Shreyas-SK-21/Braille-Reading-Analysis-System/Manuscript_Draft/diff_heatmap.pdf

Ant 1.41 | Ant 1.41 | Socks 1.22 | Socks 1.22 | Socks 1.22 | Alligator 0.99 | Alligator 0.99
Snail 0.33 | Snail 0.33 | Turtle 0.19 | Turtle 0.19 | Turtle 0.19 | Pen 0.79 | Pen 0.79
Fish 0.79 | Fish 0.79 | Switch 1.04 | Switch 1.04 | Switch 1.04 | Switch 1.04 | Knot 0.00
Cow 1.02 | Cow 1.02 | Egg 0.71 | Egg 0.71 | Elephant 0.99 | Elephant 0.99 | Elephant 0.99
Hen 0.33 | Hen 0.33 | Moon 0.60 | Moon 0.60 | Moon 0.60 | House 0.79 | House 0.79
Mango 0.69 | Mango 0.69 | Mango 0.69 | Mat 0.78 | Mat 0.78 | Scissors 0.94 | Scissors 0.94
Grape 0.66 | Grape 0.66 | Grape 0.66 | Fog 0.39 | Fog 0.39 | Frog 1.20 | Frog 1.20
