Shreyas-SK-21/Braille-Reading-Analysis-System/Manuscript_Draft/skip_heatmap.pdf

Ant 2 | Ant 2 | Socks 3 | Socks 3 | Socks 3 | Alligator 4 | Alligator 4
Snail 2 | Snail 2 | Turtle 2 | Turtle 2 | Turtle 2 | Pen 2 | Pen 2
Fish 1 | Fish 1 | Switch 2 | Switch 2 | Switch 2 | Switch 2 | Knot 1
Cow 2 | Cow 2 | Egg 1 | Egg 1 | Elephant 2 | Elephant 2 | Elephant 2
Hen 2 | Hen 2 | Moon 1 | Moon 1 | Moon 1 | House 2 | House 2
Mango 1 | Mango 1 | Mango 1 | Mat 1 | Mat 1 | Scissors 3 | Scissors 3
Grape 3 | Grape 3 | Grape 3 | Fog 2 | Fog 2 | Frog 5 | Frog 5
