Shreyas-SK-21/Braille-Reading-Analysis-System/Manuscript_Draft/tot_heatmap.pdf

Ant 1290 | Ant 1290 | Socks 1546 | Socks 1546 | Socks 1546 | Alligator 1548 | Alligator 1548
Snail 2580 | Snail 2580 | Turtle 3096 | Turtle 3096 | Turtle 3096 | Pen 1806 | Pen 1806
Fish 3093 | Fish 3093 | Switch 4131 | Switch 4131 | Switch 4131 | Switch 4131 | Knot 1543
Cow 2065 | Cow 2065 | Egg 3611 | Egg 3611 | Elephant 2835 | Elephant 2835 | Elephant 2835
Hen 2064 | Hen 2064 | Moon 4643 | Moon 4643 | Moon 4643 | House 1548 | House 1548
Mango 5673 | Mango 5673 | Mango 5673 | Mat 3098 | Mat 3098 | Scissors 1718 | Scissors 1718
Grape 1889 | Grape 1889 | Grape 1889 | Fog 1808 | Fog 1808 | Frog 1134 | Frog 1134

2000

3000

4000

5000

Dwell Time (ms)
