Shreyas-SK-21/Braille-Reading-Analysis-System/Manuscript_Draft/final_draft.pdf

# A Low-Cost Conductive Grid System for Real-Time Multi-Metric Braille Reading Performance Analysis

Abstract—Objective assessment of Braille reading proficiency remains essential yet underserved, with existing tools either prohibitively expensive or unsuitable for widespread classroom deployment. This paper presents a scalable, low-cost conductive grid-based sensing system that detects multi-touch interactions over a 7 × 7 Braille sensing grid in real time. An ESP32 microcontroller drives a multiplexed row-column scanning architecture, streaming capacitively coupled touch frames to a host system over USB-serial. A multi-threaded Python pipeline computes seven complementary performance metrics: rolling Words per Minute (WPM) with exponential moving average smoothing, velocity profile inter-quartile range (IQR) as a motor-consistency indicator, inter-word regression rate and hesitation analysis, word-level Time-on-Task (ToT), grid coverage and skip-rate analysis, path efficiency with LOWESS trend fitting, and a composite difficulty score that unifies all signals into a per-word indicator. The system operates without any wearable device or optical apparatus, providing an unobtrusive, low-cost platform for diagnosing Braille reading proficiency in classroom and research settings.
Index Terms—Braille reading, conductive grid, touch sensing, capacitive coupling, ESP32, finger tracking, WPM, time-on-task, regression analysis, path efficiency, motor consistency, accessibility, low-cost assistive technology
I. INTRODUCTION

Braille literacy remains a cornerstone of independence and academic achievement for individuals who are blind or visually impaired. Research consistently demonstrates that Braille-literate individuals enjoy substantially higher employment rates [1]; however, the National Federation of the Blind reports a severe literacy crisis wherein nearly 90% of blind children are not being taught to read and write Braille [2]. The World Health Organization further reports that vision impairment carries an annual global productivity loss of approximately US$ 411 billion [3], underscoring the economic imperative of effective tactile literacy programmes. Yet despite this importance, tools for objectively measuring and improving Braille reading skills remain scarce, expensive, and inaccessible to most educators and learners. Martiniello and Wittich [4] confirm in a comprehensive scoping review that Braille reading performance is determined by at least three independent capacity dimensions including tactile sensitivity, manual dexterity, and cognitive processing, underscoring why aggregate WPM alone is insufficient for diagnostic assessment. A systematic review of technology-supported Braille literacy education for children [5] further confirms that while electronic tools support Braille output, real-time performance monitoring systems remain absent from classroom practice, a gap the proposed platform directly addresses.

Knowlton and Wetzel [6] reported a mean Braille reading speed of 136 words per minute (WPM) for experienced readers in controlled reading tasks, with a range of 65–185 WPM. While some literature claims that highly proficient readers can achieve rates between 200 and 400 WPM [7], reflecting the upper tail of expert performance, beginners typically read at only 50-70 WPM. Understanding why a reader is slow, whether due to uneven finger movement, frequent backtracking, or inefficient reading patterns requires instrumentation that captures more than aggregate reading speed. Existing systems for analyzing Braille reading rely on vision-based tracking, wearable sensors [8]–[10], or dedicated electronic displays, all of which are intrusive, expensive, or impractical for widespread deployment.
While low-cost real-time tactile tracking has been successfully demonstrated in other contexts such as interactive museum exhibits [11], [12], there is a pressing need to adapt such non-invasive approaches to capture continuous Braille reading interaction data. This includes tracking finger movement patterns, per-cell reading durations, total reading time, and average reading rate without instrumenting the reader. This paper presents such a system. A passive conductive grid placed beneath a 7 × 7 Braille sensing grid detects finger contact events through capacitive coupling; a multi-threaded software pipeline then computes seven complementary metrics that together profile both reading fluency and motor consistency. The key contributions of this work are:
- A low-cost, non-invasive conductive grid system capable of localizing touch interactions on a physical Braille page in real time.
- A comprehensive multi-metric analysis of Braille reading performance by quantifying reading fluency, fingermotion stability, regressions and hesitations, time-on-task behavior, reading coverage, path efficiency, and overall word-level difficulty.

II. RELATED WORK

Prior approaches to Braille reading analysis can be broadly categorized into four classes: marker-based tracking systems, wearable sensor systems, software-based tablet solutions, and vision-based and electronic approaches.
Early Braille-reading studies relied on external tracking hardware to capture finger motion. Hughes [13] used a digitizing tablet to analyze Braille reading kinematics, revealing frequent velocity fluctuations and smoother motion profiles among skilled readers. Similarly, Aranyanak and Reilly [14]

developed a Wiimote-based infrared tracking system that monitored LEDs attached to readers’ fingers while supporting both embossed Braille and refreshable displays. Although these systems provide valuable movement data, they require markers to be attached to the reader, careful calibration, and specialized hardware that limits practical classroom deployment. Several wearable approaches have been proposed for Braille reading assistance and analysis. Recent motion-sensor based systems like BrailleReader [15] leverage wrist kinematics for Braille tracking, while the Finger-Eye system [16] combines a miniature camera with electro-tactile feedback to guide users during reading. While these approaches can achieve high precision, they require users to wear and calibrate additional hardware, potentially altering the natural reading experience. Building on earlier camera-based finger-tracking systems for Braille [17], Aranyanak [18] replaced the camera with a capacitive touchscreen, proposing a tablet-based finger-tracking system in which transparent Braille paper is placed over the screen. The system records finger movement patterns, reading durations, and reading speed while preserving a largely non-invasive interaction. However, it is limited to specific tablet hardware, supports only two-finger tracking, and constrains the reading area to the dimensions of the touchscreen. More recently, Marzi et al. [19] extended surface-based finger-tracking to the analysis of reading pace, word-level dwell time, and regression frequency in ASD children, demonstrating that non-invasive, touchscreen-based trajectory recording can yield diagnostically meaningful multi-metric profiles, a capability the proposed system brings to physical embossed Braille. Refreshable Braille displays with integrated sensing capabilities are commercially available but are often expensive and restricted to electronic content. Even recent low-cost display innovations such as BLISS [20], which reuses Braille pins for multi-character display, remain hardware-intensive output devices unsuited to the passive sensing role required for reading behavior analysis. State-of-the-art electromagnetic Braille displays [21] achieve reliable multi-cell actuation but provide no mechanism for capturing or analyzing how a reader interacts with the content. Vision-based approaches use cameras and computer-vision algorithms to track finger movement [17], but are sensitive to lighting conditions, occlusion, reader posture, and privacy concerns, making reliable deployment challenging. A common limitation across prior work is the extraction of only a limited set of performance metrics, typically reading speed or error rate. Kong et al. [22] demonstrated that 15 mathematically formalized touch metrics including touch drift, direction, and area variability to differentiate between finemotor-impaired and unimpaired users on capacitive touch screens, establishing a framework that parallels and motivates our multi-metric approach for Braille interaction. No existing low-cost system simultaneously tracks velocity consistency, word-level dwell time, regression patterns, skip rate, and path efficiency within a unified real-time pipeline. The proposed system addresses this gap.
Table I provides a qualitative comparison across four practical dimensions: cost, invasiveness, real-time operation, and

TABLE I
COMPARISON OF BRAILLE READING ANALYSIS SYSTEMS
System | Low Cost | Non-Invasive | Real-Time | Vision Free | Per-word Metrics
Marker-based [13], [14] Wearable [15], [16] Tablet touch [18] Vision-based [17] Braille display [21], [23] Proposed | ✓ ✓ ✓ ✓ × ✓ | × × ✓ ✓ ✓ ✓ | ✓ ✓ ✓ ✓ ✓ ✓ | ✓ ✓ ✓ × ✓ ✓ | × × Limited × × ✓

Per-word Metrics includes simultaneous real-time tracking of WPM, velocity IQR, regression rate, time-on-task, skip rate, path efficiency η, and composite difficulty D.

per-word metric granularity. No currently published system provides a directly comparable low-cost, real-time, multi-metric pipeline against which head-to-head quantitative benchmarking is possible. Our core objective was to automate a process currently performed manually—recording sessions on video and analyzing finger movement post-hoc—which is time-consuming and impractical for classroom-scale use. Quantitative benchmarking against an external reference system is planned as part of the forthcoming evaluation with visually impaired readers.

III. PROPOSED SYSTEM

A. System Overview
The proposed system consists of three components: (i) a passive conductive grid embedded beneath a Braille reading surface, with software-defined mapping between Braille content and grid coordinates; (ii) an ESP32 microcontroller board that drives multiplexed row–column scanning and streams capacitively coupled touch frames to a host system over USB– serial; and (iii) a multi-threaded Python software pipeline that computes seven reading performance metrics in real time and renders a eight-panel live visualization suite. No modifications to the Braille page or the reader’s hands are required.
The system actively tracks dual-finger interactions using a proximity-based peak-lock assignment algorithm. This allows it to explicitly capture multi-finger reading strategies like the butterfly and side-by-side patterns while calculating independent metrics for each finger.
B. Hardware Design
1) Cost-Efficient Conductive Grid Architecture: The sensing layer is a 7 × 7 prototype matrix of conductive copperstrip traces, providing 49 sensing locations mapped to single word positions. The physical layout is shown in Fig. 1. It is important to note that the 7 × 7 grid presented in this study serves as an evaluative mockup: to accurately mimic the spatial layout of an authentic embossed Braille sheet placed over the system, a single logical word is assigned across multiple contiguous sensing cells, with the number of cells proportional to the word’s character length. A defining feature of this prototype is its extreme cost-efficiency. The sensing grid is constructed entirely from commodity copper tape, which retails for under $0.50 per metre. The data acquisition is driven by an ESP32 microcontroller development board, available for approximately $4–5 USD. The only comparatively expensive component is the pair of analog multiplexer ICs (CD4051) required for row–column switching, at roughly $0.80 USD total. Even with all passive components, cabling, and a perfboard, the complete hardware bill of materials is bounded at approximately $14–18 USD per unit. While it does not replace the spatial precision of laboratory eyetracking rigs or high-end instrumented Perkins Braillers, this $18 proof-of-concept provides a highly scalable, accessible alternative for resource-constrained environments (e.g., public school classrooms) where $10,000 systems are prohibitively expensive.

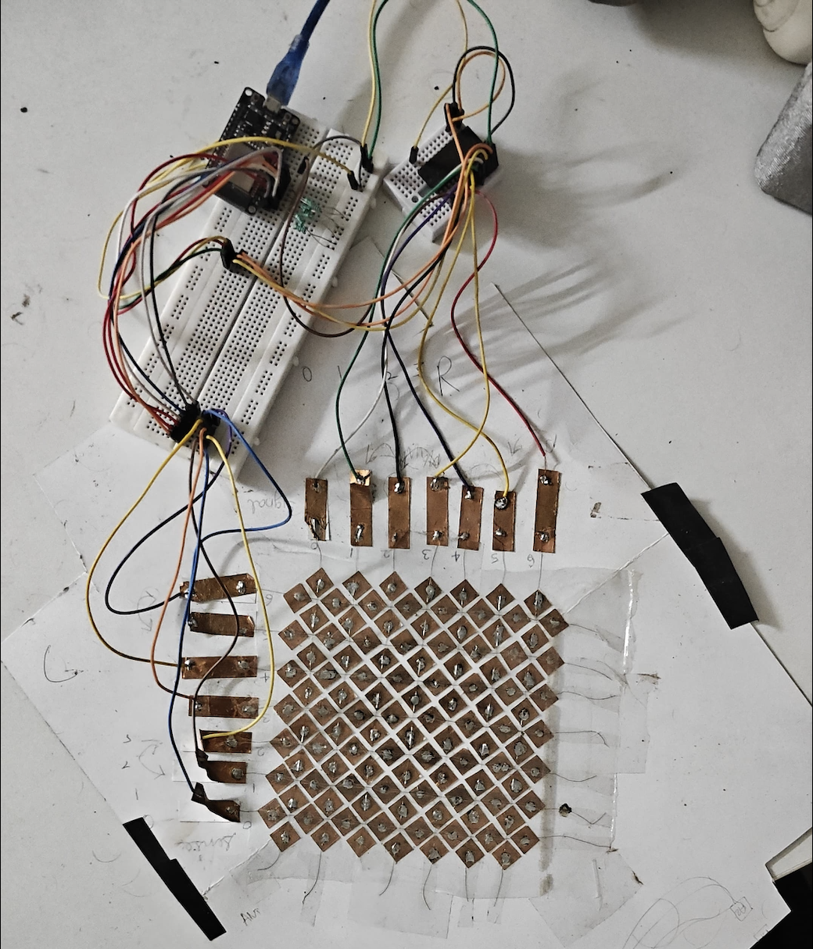
[picture p10: figure]

Fig. 1. Physical layout of the 7 × 7 conductive grid with ESP32 controller board.
2) Excitation Signal and Scanning: A hardware timer generates a ∼100 KHz square-wave excitation signal. Electromagnetic interference (EMI) rejection relies on software-based baseline subtraction and amplitude thresholding rather than passive filtering. The AC carrier is routed through each selected transmit (TX) row in turn, and capacitively coupled signals are detected on the receive (RX) column lines when a finger bridges an intersection.
A 3-bit multiplexer selects one TX row at a time, followed by a 25 µs settling delay to allow the RC network to stabilize before sampling the RX columns. Each ADC reading averages 30 successive 12-bit samples to filter noise. Touch-induced differential signals fall within the 0.15–2.8 V range, avoiding the ESP32 ADC’s non-linear regions near the voltage rails. This process generates a full 7 × 7 activation frame per scan cycle, transmitted to the host via USB-serial.
C. Firmware Flowchart
Fig. 2 illustrates the ESP32 firmware control flow, which orchestrates the complete scan–filter–transmit cycle. The main loop iterates over all seven TX rows, selects each via the multiplexer, and reads all seven RX columns with a 30-sample averaged ADC filter. Frame timestamps are derived from the microcontroller’s hardware timer to support latency measurement. The resulting 7 × 7 activation matrix is transmitted to the host.

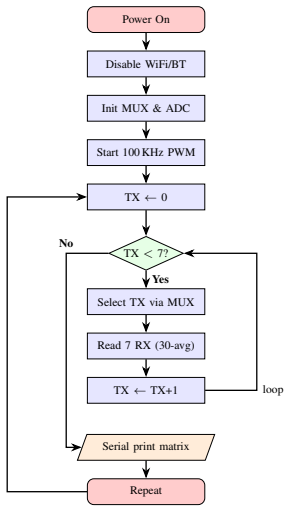
[picture p11: figure]
Power On; Disable WiFi/BT; Init MUX & ADC; Start 100 KHz PWM; Select TX via MUX; Read 7 RX (30-avg); Serial print matrix; Repeat; Yes; loop

Fig. 2. ESP32 firmware control flow: multiplexed row scanning with filtered ADC readout and serial transmission.

D. Software Pipeline
The host-side pipeline runs three concurrent threads: a reader thread that flushes stale serial data and posts the most recent 7×7 frame to a bounded queue, a metrics thread that dequeues frames, runs touch detection, and updates all tracker objects, and a UI thread that reads metric snapshots and renders the visualisation suite. All tracker classes expose an asynchronous snapshot method to decouple high-speed sensing from UI rendering. The pipeline is illustrated in Fig. 3.

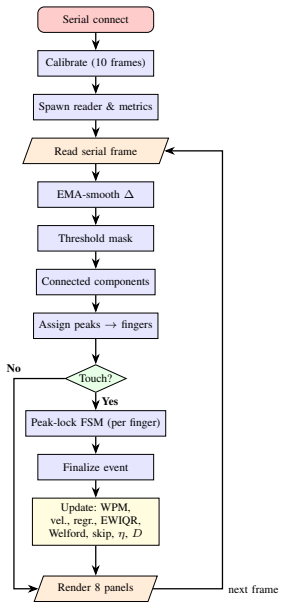
[picture p12: figure]
Serial connect; Calibrate (10 frames); Spawn reader & metrics; Read serial frame; EMA-smooth ∆; Threshold mask; Connected components; Assign peaks → fingers; Touch?; Peak-lock FSM (per finger); Finalize event; Update: WPM, vel., regr., EWIQR, Welford, skip, η, D; Render 8 panels; Yes; next frame

Fig. 3. Software pipeline: three-thread serial ingestion, dual-finger touch detection via connected-component analysis and per-finger peak-lock FSM, eight metric trackers (D = composite difficulty score), and eight-panel live visualisation.
Raw activation frames are processed by a 4-connected component algorithm that clusters adjacent activated cells into discrete touch events. Each event is assigned a centroid coordinate, a timestamp, a duration and a word_label derived from a pre-calibrated mapping of grid coordinates to the word boundary dictionary. A peak-lock finite state machine stabilizes the detected cell across frames and detects mid-touch slides when the finger moves ≥2 cells (Manhattan distance), automatically finalizing the current event and starting a new one without requiring lift-off.
The system dynamically maps varying physical column widths to word boundaries using a software-defined dictionary. A WordGroupAccumulator gates word registration until all multi-block segments of a single word have been traversed. WPM is then computed over a 60-second rolling window: where nw(t) is the touch count within ∆T = 60 s. An EMA with α = 0.15 is applied after a median pre-filter (window=3) to reduce per-frame variance, also expressed in the Equation 1, where x˜t is the median-filtered WPM sample. The smoothing factor α = 0.15 was selected heuristically to balance lag against variance: smaller values suppress measurement jitter but delay trend detection, while larger values track instantaneous speed bursts at the cost of noise amplification. The chosen value yields an effective memory window of approximately 1/α ≈ 7 samples, which aligns with the expected temporal scale of deliberate reading-speed changes during a session.
WPM \t = α · x˜t + (1 − α) · WPM \t−1 | (1)

The Velocity-Tracker employs an exponentially weighted IQR (EWIQR) algorithm with decay factor of λ = 0.95. For each touch event, the velocity profile (cells/s) between consecutive path steps is recorded with exponentially decaying weights as expressed in the Equation 2: , where clamp(x, a, b) = min(max(x, a), b) constrains the result to the interval [a, b]; here a = 0 and b = 1 ensure Cs remains a valid normalized score.

v¯ =

P
| i wivi

P
i wi

,
IQR = Q75 − Q25,
Cs = clamp
1 −

IQR
max(¯v, ε)

, 0, 1

(2)

This formulation is motivated by Nonaka et al. [24], who demonstrated that the inter-event structure of lateral-velocity fluctuations longitudinally predicts Braille reading proficiency in blind children, establishing velocity variability as a principled motor-consistency indicator.
A regression occurs when the reader returns to a previously touched word. The Word-Stats-Tracker maintains a seen set mapping words to their last-touch timestamp. To prevent false regressions during prolonged reading or multi-pass exploration, a time-windowed regression algorithm is employed: a touch is only counted as a regression if the same cell was touched within a 30-second temporal window. Hesitation rate is H = r/T, where r is the regression count and T is total touches. Words with regression count > 3 are flagged as difficulty candidates.

Time-on-Task for word w is the mean contact duration, calculated continuously using a Welford online algorithm. A 7×7 numpy array ZToT is maintained for the 2D performance heatmap visualization.
Considering N as the total number of mapped word regions (49 selected in the current 7 × 7 prototype), Skip rate is defined as: A BFS cluster analysis classifies skip patterns into categories (sensing failure, column alignment, boundary avoidance, saccade drift).
The path efficiency is defined as per the Equation 3, where dstraight is the Euclidean distance between the first and last cells visited within a touch event, and dactual is the cumulative arc length of the detected finger path. A LOWESS trend (f =
0.3) is recomputed every 10 events.

η =

dstraight

dactual

, | η ∈ (0, 1], | (3)

The composite difficulty score D(e) for a touch event e aggregates four kinematic and behavioral signals into a single indicator of reading effort:

D(e) = w1REV(e) + w2ZC(e) + w3VEL(e) + w4WREV(e)
| | (4)
where REV(e) represents the number of within-touch path direction reversals, ZC(e) denotes the count of zero-crossings in the velocity profile indicating hesitation, VEL(e) = ¯v/(¯v +
1) ∈ [0, 1) is a normalized speed term that increases toward unity as mean finger velocity v¯ increases, and WREV(e) is a binary flag indicating if the event constitutes a sessionlevel inter-word regression. The word-level difficulty D(w) is then computed as the arithmetic mean of D(e) for all events mapped to word w. In the current prototype, the heuristic weights are set to w1 = 1.0, w2 = 0.5, w3 = 2.0, and w4 = 1.5. These weights were empirically chosen to prioritize regression penalties. Exploratory Principal Component Analysis (PCA) revealed that sighted participants exhibit a tactile “scrubbing” behavior (high hesitation correlating with high velocity), which inverts the kinematics of proficient blind readers. Thus, deriving static statistical weights was deliberately deferred to future clinical studies to prevent overfitting to sighted behavior. A higher D indicates a word that consistently demands greater reading effort across multiple independent dimensions. Reading difficulty variance is rendered as a switchable view in the 7 × 7 2D performance heatmap, driven by an Exponentially Weighted Interquartile Range (EWIQR) of touch durations, which isolates current reading inconsistency.

IV. EXPERIMENTAL RESULTS AND DISCUSSION
The results presented in this section were obtained through a pilot evaluation conducted with sighted participants interacting with the 7 × 7 grid surface. This evaluation was performed to validate system functionality, metric computation, and visualization pipeline. These results should be interpreted as a proof-of-concept demonstration of system capability; formal user studies with visually impaired Braille readers remain as future work (Section V).

A. Experimental Setup and Pilot Protocol

To characterize system performance and validate the software pipeline, empirical hardware tests were conducted across multiple independent reading sessions. To accommodate the variety of target words on the prototype’s 7 × 7 spatial footprint, different sets of words were mapped and tested in separate passes. The integrated system successfully processed continuous touch events across all 49 grid positions in real-time, yielding rich datasets for metric extraction. Sighted participants were blindfolded to eliminate visual feedback, strictly isolating tactile exploration and mirroring the operational constraints of visually impaired readers. The 7 × 7 evaluation grid assigns each logical word across one or more contiguous sensing cells based on character length, mimicking the spatial layout of an authentic embossed Braille sheet.

B. WPM Accuracy and EMA Stability

The two-stage median→EMA pipeline (Eq. 1, α = 0.15) significantly reduces per-frame WPM variance relative to raw rolling counts. Fig. 4 shows a time series extraction demonstrating the smoothed EMA trend overlaid on the raw windowed count. By mitigating localized noise from finger jitters, the pipeline provides a stable, continuous reading speed metric that accurately reflects the user’s tactile reading pace against established novice benchmarks [6].

0 | 10 | 20 | 30 | 40 | 50

0

10

20

30

40

17 WPM (novice floor)

Touch event index

WPM

Raw rolling WPM
EMA trend (α=0.15)

Fig. 4. WPM time series extraction: raw rolling count (grey) with median→EMA trend overlay (α = 0.15, blue). Dashed reference marks the established novice tactile reading floor [6].

C. Velocity IQR and Motor Consistency

Fig. 5 shows the velocity profile overlay for a a continuous reading sample. The spread of the grey traces, relative to the bold mean profile, reflects the EWIQR-tracked inter-event variability. A narrowing spread over an evaluation period indicates improving motor consistency, captured by Cs (Equation 2).

0 | 2 | 4 | 6

0

2

4

6

Path step

Velocity (cells/s)

Past traces
Latest trace
Weighted mean

Fig. 5. Velocity profile overlay: grey traces = past 20 events; blue = most recent; dashed orange = exponentially weighted mean. Spread of grey traces reflects EWIQR-tracked motor variability.

D. Hesitation Rate and Regressions
Fig. 6 shows the regression frequency chart generated by the Word-Stats-Tracker. Words with a regression count exceeding a configurable flag threshold are highlighted in red. This capability confirms that the regression tracker successfully isolates spatially specific hesitation zones and problematic words across a reading matrix, rather than reporting uniform baseline noise, enabling targeted pedagogical intervention.
0.0 | 0.5 | 1.0 | 1.5 | 2.0 | 2.5 | 3.0
Regression Count

Alligator

Frog

Socks

Scissors

Grape

Elephant

Cow

Ant

Hen

Pen

House

Snail

Switch

Turtle

Fig. 6. Regression frequency chart (aggregated system evaluation data): red bars mark flagged words whose regression counts exceed a configured threshold, demonstrating the system’s ability to isolate spatially localised hesitation targets.
Words flagged by the regression tracker overlapped with high composite difficulty scores, confirming convergent validity across independent metrics. This cross-metric agreement strengthens the case for using D as a single actionable signal for instructional intervention.
Figs. 7 and 8 show the 2D performance heatmaps generated by the visualization pipeline. The Time-on-Task (ToT) metric provides high-resolution temporal profiles for individual Braille cells, directly reflecting the motor difficulty and dwell time of specific segments. The composite difficulty score D effectively aggregates these signals, identifying the highesteffort regions across the reading matrix independent of simple Time-on-Task. For instance, Ant (D = 1.41) and Socks (D = 1.22) dominate as the hardest words by composite difficulty.
C0 | C1 | C2 | C3 | C4 | C5 | C6

R0

R1

R2

R3

R4

R5

R6

1290
(Ant)

1290
(Ant)

1545
(Socks)

1545
(Socks)

1545
(Socks)

1548
(Alligator)

1548
(Alligator)

2580
(Snail)

2580
(Snail)

3095
(Turtle)

3095
(Turtle)

3095
(Turtle)

1805
(Pen)

1805
(Pen)

3093
(Fifth)

3093
(Fifth)

4130
(Switch)

4130
(Switch)

4130
(Switch)

4130
(Switch)

1542
(Knot)

2064
(Cow)

2064
(Cow)

3611
(Egg)

3611
(Egg)

2834
(Elephant)

2834
(Elephant)

2834
(Elephant)

2063
(Hen)

2063
(Hen)

4643
(Moon)

4643
(Moon)

4643
(Moon)

1548
(House)

1548
(House)

5672
(Mango)

5672
(Mango)

5672
(Mango)

3098
(Mat)

3098
(Mat)

1717
(Scissors)

1717
(Scissors)

1889
(Grape)

1889
(Grape)

1889
(Grape)

1808
(Fog)

1808
(Fog)

1134
(Frog)

1134
(Frog)

2000

3000

4000

5000

Dwell Time (ms)

Fig. 7. 7 × 7 Time-on-Task heatmap (aggregated empirical data, ms). Blue intensity encodes mean dwell time; darker = longer. Variations in dwell time are visualized to pinpoint reading struggles. Note: To visualize regional difficulty, cognitive metrics (such as dwell time) are aggregated at the logical word-level and projected uniformly across the spatial grid cells occupied by that word.

C0 | C1 | C2 | C3 | C4 | C5 | C6

R0

R1

R2

R3

R4

R5

R6

1.41
(Ant)

1.41
(Ant)

1.22
(Socks)

1.22
(Socks)

1.22
(Socks)

0.99
(Alligator)

0.99
(Alligator)

0.33
(Snail)

0.33
(Snail)

0.19
(Turtle)

0.19
(Turtle)

0.19
(Turtle)

0.79
(Pen)

0.79
(Pen)

0.79
(Fifth)

0.79
(Fifth)

1.04
(Switch)

1.04
(Switch)

1.04
(Switch)

1.04
(Switch)

0.00
(Knot)

1.02
(Cow)

1.02
(Cow)

0.71
(Egg)

0.71
(Egg)

0.99
(Elephant)

0.99
(Elephant)

0.99
(Elephant)

0.33
(Hen)

0.33
(Hen)

0.60
(Moon)

0.60
(Moon)

0.60
(Moon)

0.79
(House)

0.79
(House)

0.69
(Mango)

0.69
(Mango)

0.69
(Mango)

0.78
(Mat)

0.78
(Mat)

0.94
(Scissors)

0.94
(Scissors)

0.66
(Grape)

0.66
(Grape)

0.66
(Grape)

0.39
(Fog)

0.39
(Fog)

1.20
(Frog)

1.20
(Frog)

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
Composite Difficulty (D)

Fig. 8. 7 × 7 composite difficulty heatmap (aggregated empirical data D). Red (D ≥ 0.90) = high effort; yellow (0.50 ≤ D < 0.90) = moderate; white = low. The metric effectively isolates the hardest regions. Note: Similar to Time-on-Task, difficulty scores are aggregated at the word-level and projected onto corresponding cells.

E. Skip Rate and Grid Coverage
The coverage heatmap (Fig. 9) shows the spatial distribution of total touch counts across the grid positions, demonstrating the system’s ability to map spatial exploration. By highlighting baseline touches and heavily revisited regions, the metric verifies that the hardware captures complete grid coverage while mapping spatial inconsistencies. Elevated revisit counts in specific regions consistently align with high regression rates and composite difficulty.
C0 | C1 | C2 | C3 | C4 | C5 | C6

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
(Ant)

2
(Ant)

3
(Socks)

3
(Socks)

3
(Socks)

4
(Alligator)

4
(Alligator)

2
(Snail)

2
(Snail)

2
(Turtle)

2
(Turtle)

2
(Turtle)

2
(Pen)

2
(Pen)

1
(Fifth)

1
(Fifth)

2
(Switch)

2
(Switch)

2
(Switch)

2
(Switch)

1
(Knot)

2
(Cow)

2
(Cow)

1
(Egg)

1
(Egg)

2
(Elephant)

2
(Elephant)

2
(Elephant)

2
(Hen)

2
(Hen)

1
(Moon)

1
(Moon)

1
(Moon)

2
(House)

2
(House)

1
(Mango)

1
(Mango)

1
(Mango)

1
(Mat)

1
(Mat)

3
(Scissors)

3
(Scissors)

3
(Grape)

3
(Grape)

3
(Grape)

2
(Fog)

2
(Fog)

5
(Frog)

5
(Frog)

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
Touch Count

Fig. 9. Grid coverage map (aggregated touch counts). Light green = 1–2 touches; dark green = 3–5 (high revisit rate). The system maps full coverage and successfully highlights heavily re-explored areas without any skipped cells in this session.
Because this representative reading session achieved complete spatial coverage (no unvisited cells), it demonstrates the participant’s thorough tactile scanning. In sessions where skipped cells cluster in lower grid rows, it typically indicates that observation duration, rather than intrinsic word difficulty, drives unvisited regions. Skip rates should therefore be normalized by observation duration when comparing reading behaviors across participants or conditions.
F. Path Efficiency and Composite Difficulty
The path efficiency metric η (Eq. 3) quantifies the directness of the reader’s finger trajectory, distinguishing between discrete, well-centred taps and ambiguous sliding motions. A consistently high η baseline confirms that the physical grid successfully resolves precise tactile interactions, proving the system capable of tracking prolonged reading activity without sensor degradation or baseline drift.
0 | 1 | 2 | 3 | 4 | 5 | 6 0
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
Column

Row

Difficulty

D

0

0.5

1

D

Fig. 10. 7 × 7 composite difficulty surface (aggregated empirical data, hot2 colormap). Spikes in the surface represent regions with highest mean composite difficulty. Grey positions denote unvisited cells.
Analysis of these surface mappings confirms that the composite metric D produces stable, reproducible word-level difficulty profiles rather than transient, session-specific noise, serving as a reliable indicator of pedagogical challenge.
G. System Latency
Real-time tracking requires low end-to-end system latency. The innate hardware latency of the sensing grid and ESP32 transmission, excluding the Python processing pipeline, is approximately 55-60 ms. The Python code computation latency for touch localization, metric updates, and rendering is 33 ms per frame. The combined end-to-end latency is approximately 95 ms, which is well below human perception thresholds for tactile feedback, ensuring highly responsive multi-metric tracking during live reading sessions.
H. Composite Score Sensitivity
The composite difficulty score D currently uses fixed heuristic weights (W1=1.0, W2=0.5, W3=2.0, W4=1.5). To demonstrate the adaptability of the composite score for different pedagogical needs, Table II compares word difficulty rankings across three varying weight configurations. The highdifficulty cluster (Ant, Socks, Frog) dominates across presets, but their relative rankings shift logically: Speed-Focused weights elevate slow-read words like Cow and Socks, while Accuracy-Focused weights strongly penalize high-regression words like Alligator and Frog.

TABLE II
SENSITIVITY ANALYSIS: TOP-7 WORD DIFFICULTY RANKINGS UNDER THREE WEIGHT PRESETS
Rank | Default (W1=1.0, W3=2.0) | Speed-Focused (W3=3.0) | Accuracy-Focused (W1=2.0)
1 2 3 4 5 6 7 | Ant Socks Frog Switch Cow Alligator Elephant | Socks Ant Cow Frog Switch Elephant Alligator | Frog Alligator Socks Ant Switch Cow Elephant
V. LIMITATIONS AND FUTURE WORK
The current prototype is limited by its hand-made 7×7 parallel grid pattern and sequential row-polling scan architecture, which restrict temporal resolution, localization accuracy, and full-page coverage. Furthermore, while the system successfully tracks dual distinct touch points via proximity assignment, it cannot currently determine absolute finger identity or operate at natural reading pressures without potential false touches. Future work will adopt an interleaved, high-resolution grid with continuous parallel sensing to improve spatial and temporal fidelity, as well as investigate alternative low-force sensing modalities.
The primary limitation of this study is that the pilot evaluation was conducted exclusively with sighted participants, and results have not yet been validated with visually impaired Braille readers — the primary target population. Sighted participants rely on visual feedback, lack haptic memory for Braille dot patterns, and produce systematically different regression and skip-rate profiles than experienced blind readers. Consequently, the absolute metric values reported here (WPM, regression rates, composite difficulty scores) should not be interpreted as representative of the target population. Institutional approval has been secured for clinical deployment of this prototype with visually impaired students. The upcoming study protocol will recruit n ≥ 20 participants spanning beginner, intermediate, and advanced Braille readers. The platform’s non-invasive, passive sensing design makes it suitable for classroom deployment without modification, and the sevenmetric pipeline requires no re-calibration between participants. An additional hardware limitation is the signal-to-noise ratio (SNR) attenuation caused by standard dielectric Braille paper (e.g., 120–160 gsm cardstock). The heavy reliance on aggressive software smoothing (such as the α = 0.15 exponential moving average and median filters) is a deliberate engineering trade-off to compensate for this attenuation while using low-cost commodity copper tape. Formal characterization of dielectric attenuation and baseline SNR optimization without heavy software filtering is planned for the next hardware iteration.

VI. CONCLUSION
This paper presented a low-cost, non-invasive conductive grid system for real-time multi-metric analysis of Braille reading behavior. By utilizing commodity copper tape and an ESP32 microcontroller, the prototype captures spatial and temporal reading patterns—including WPM, regression rates, and a composite difficulty score—at a fraction of the cost of commercial alternatives. Pilot evaluations demonstrated the system’s ability to successfully track and isolate reading hesitations and motor inconsistencies through a unified software pipeline. Future work will deploy this scalable, passive sensing platform in formal user studies with visually impaired readers to advance data-driven Braille literacy instruction.

REFERENCES

[1] R. Ryles, “The impact of braille reading skills on employment, income, education, and reading habits,” Journal of Visual Impairment & Blindness, vol. 90, no. 3, pp. 219–226, 1996.
[2] National Federation of the Blind Jernigan Institute, “The braille literacy crisis in america: Facing the truth, reversing the trend, empowering the blind,” tech. rep., National Federation of the Blind, Baltimore, Maryland, 2009.
[3] World Health Organization, World Report on Vision. | Geneva,
Switzerland: WHO, 2019. | https://www.who.int/publications/i/item/
9789241516570.
[4] N. Martiniello and W. Wittich, “The association between tactile, motor and cognitive capacities and braille reading performance: a scoping review of primary evidence to advance research on braille and aging,” Disability and Rehabilitation, vol. 44, no. 11, pp. 2515–2536, 2022.
[5] E. R. Hoskin, M. K. Coyne, M. J. White, S. C. Dobri, T. C. Davies, and S. D. Pinder, “Effectiveness of technology for braille literacy education for children: a systematic review,” Disability and Rehabilitation: Assistive Technology, vol. 19, no. 1, pp. 120–130, 2024.
[6] M. Knowlton and R. Wetzel, “Braille reading rates as a function of reading tasks,” Journal of Visual Impairment & Blindness, vol. 90, no. 3, pp. 227–236, 1996.
[7] G. E. Legge, C. M. Madison, and J. S. Mansfield, “Measuring braille reading speed with the mnread test,” Visual Impairment Research, vol. 1, no. 3, pp. 131–145, 1999.
[8] D. Singhal, Y. Gupta, D. Sharma, C. Sultania, and M. Rao, “Hapticguide: Interactive wearable braille guide for enhancing visual education,” in 2025 38th International Conference on VLSI Design and 24th International Conference on Embedded Systems (VLSID), (Bangalore, India), pp. 73–78, IEEE, 2025.
[9] D. Singhal, C. Sultania, A. Madurwar, M. Kabra, and M. Rao, “Braille on mouse - enhancing accessibility of digital education for visually challenged,” in 2024 16th International Conference on Computer and Automation Engineering (ICCAE), (Melbourne, Australia), pp. 41–45, IEEE, 2024.
[10] C. Sultania, D. Singhal, M. Kabra, A. Madurwar, S. Pawar, and M. Rao, “Wearable haptic braille device for enhancing classroom learning,” in 2023 IEEE SENSORS, (Vienna, Austria), pp. 1–4, IEEE, 2023.
[11] A. Ramesh, N. Raj, T. K. Srikanth, and M. Rao, “Design of a tactile audio gallery for visually impaired students,” in 2019 IEEE SENSORS, (Montreal, QC, Canada), pp. 1–4, IEEE, 2019.
[12] N. Raj, A. Ramesh, T. K. Srikanth, and M. Rao, “Live demonstration: A tactile audio gallery for visually impaired students,” in 2019 IEEE SENSORS, (Montreal, QC, Canada), pp. 1–1, IEEE, 2019.
[13] B. Hughes, “Movement kinematics of the braille-reading finger,” Journal of Visual Impairment & Blindness, vol. 105, no. 6, pp. 370–381, 2011.
[14] I. Aranyanak and R. G. Reilly, “A system for tracking braille readers using a wii remote and a refreshable braille display,” Behavior Research Methods, vol. 45, no. 1, pp. 216–228, 2013.
[15] X. Liu, F. Li, Y. Cao, and Y. Wang, “Braillereader: Braille character recognition using wearable motion sensor,” IEEE Transactions on Mobile Computing, vol. 23, no. 11, pp. 10538–10553, 2024.
[16] M. Rahimi, Y. Shen, C. Peng, Z. Liu, and F. Jiang, “Opto-electrotactile feedback enabled text-line tracking control for a finger-wearable reading aid for the blind,” in 2022 International Conference on Robotics and Automation (ICRA), pp. 7007–7013, IEEE, 2022.
[17] B. Breidegard, “Computer-based automatic finger-and speech-tracking system,” Behavior research methods, vol. 39, no. 4, pp. 824–834, 2007.
[18] I. Aranyanak, “A finger-tracking system for studying braille reading on a tablet,” in 2018 3rd International Conference on Computer and Communication Systems (ICCCS), pp. 109–112, IEEE, 2018.
[19] C. Marzi, A. Narzisi, A. Milone, G. Masi, and V. Pirrelli, “Reading behaviors through patterns of finger-tracking in italian children with autism spectrum disorder,” Brain Sciences, vol. 12, no. 10, p. 1316, 2022.
[20] M. Etezad, R. Joshi, R. Alexander, and F. L. Cibrian, “3d-printed models for optimizing tactile braille & shape display,” IEEE Transactions on Haptics, vol. 17, no. 4, pp. 782–793, 2024.
[21] H. Chen, W. Tao, C. Liu, Q. Shen, Y. Wu, L. Ruan, and W. Yang, “A novel refreshable braille display based on the layered electromagnetic driving mechanism of braille dots,” IEEE Transactions on Haptics, vol. 16, no. 1, pp. 96–105, 2023.
[22] J. Kong, M. Zhong, J. Fogarty, and J. O. Wobbrock, “Quantifying touch: New metrics for characterizing what happens during a touch,” in Proceedings of the 24th International ACM SIGACCESS Conference on Computers and Accessibility, ASSETS ’22, (New York, NY, USA), Association for Computing Machinery, 2022.
[23] M. M. H. Saikot and K. R. I. Sanim, “Refreshable braille display with adjustable cell size for learners with different tactile sensitivity,” IEEE Transactions on Haptics, vol. 15, no. 3, pp. 582–591, 2022.
[24] T. Nonaka, K. Ito, and T. A. Stoffregen, “Structure of variability in scanning movement predicts braille reading performance in children,” Scientific reports, vol. 11, no. 1, p. 7182, 2021.
