Shreyas-SK-21/Braille-Reading-Analysis-System/Firmware/row_sweeps/20260817_230511_velocity_profile.png

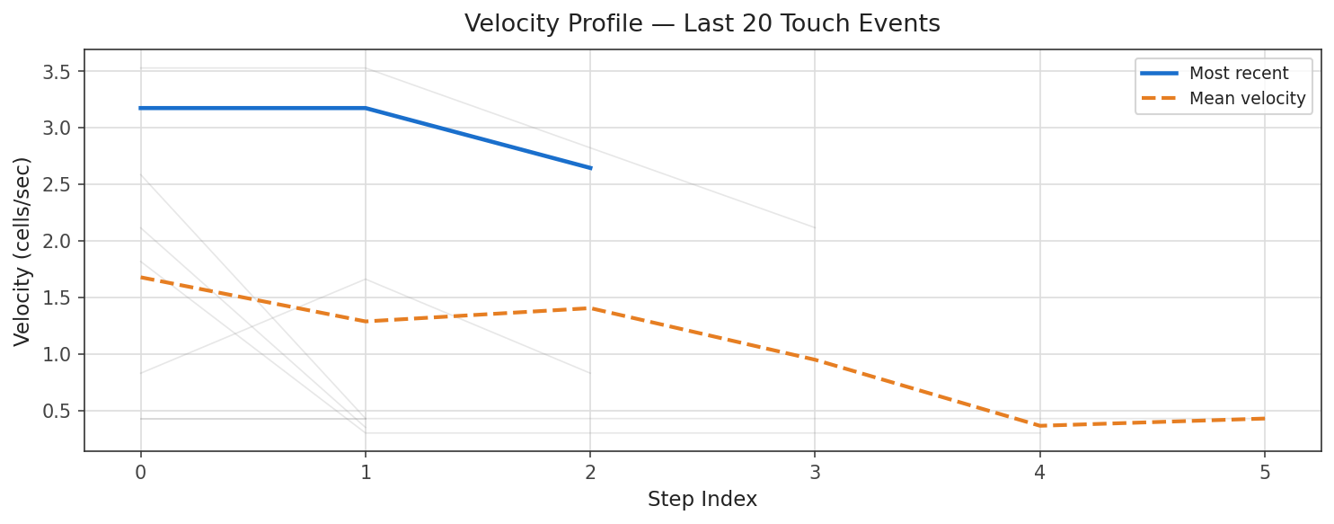
Firmware/row_sweeps/20260817_230511_velocity_profile.png
