Shreyas-SK-21/Braille-Reading-Analysis-System/Firmware/RUN1/20260824_001119_regression_chart.png

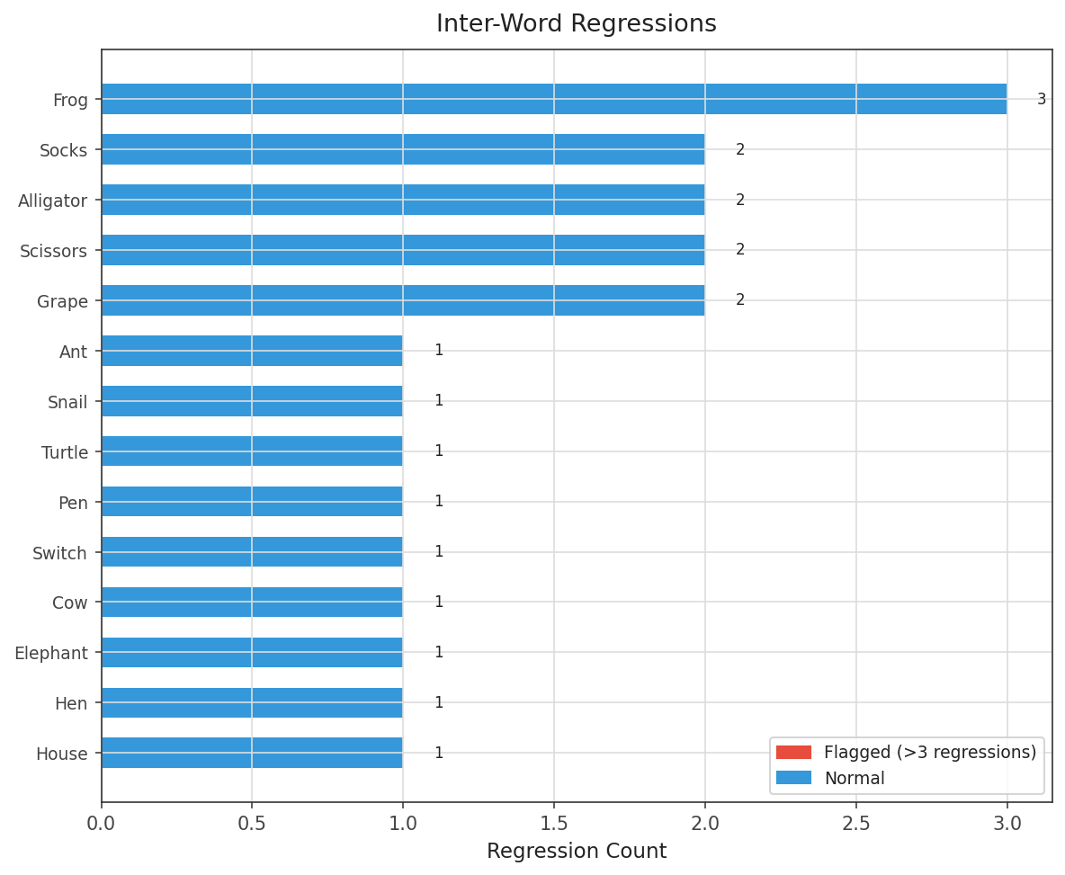
Firmware/RUN1/20260824_001119_regression_chart.png
