Shreyas-SK-21/Braille-Reading-Analysis-System/Firmware/run1_full matrix/20260814_210314_velocity_profile.png

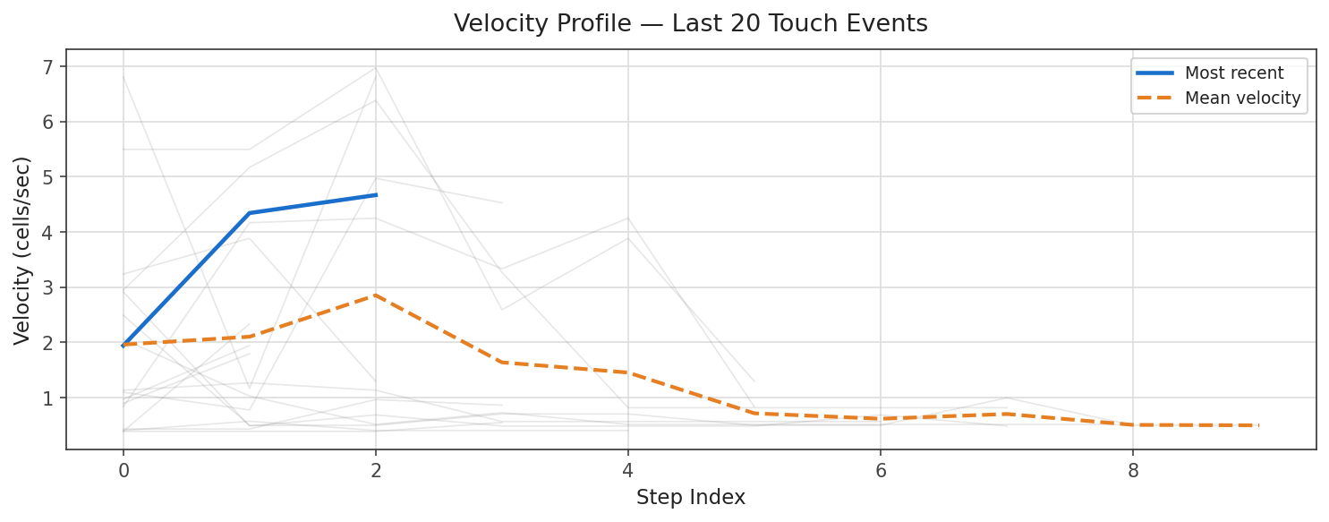
Firmware/run1_full matrix/20260814_210314_velocity_profile.png
