Shreyas-SK-21/Braille-Reading-Analysis-System/Firmware/RUN2/20260824_001934_difficulty_heatmap.png

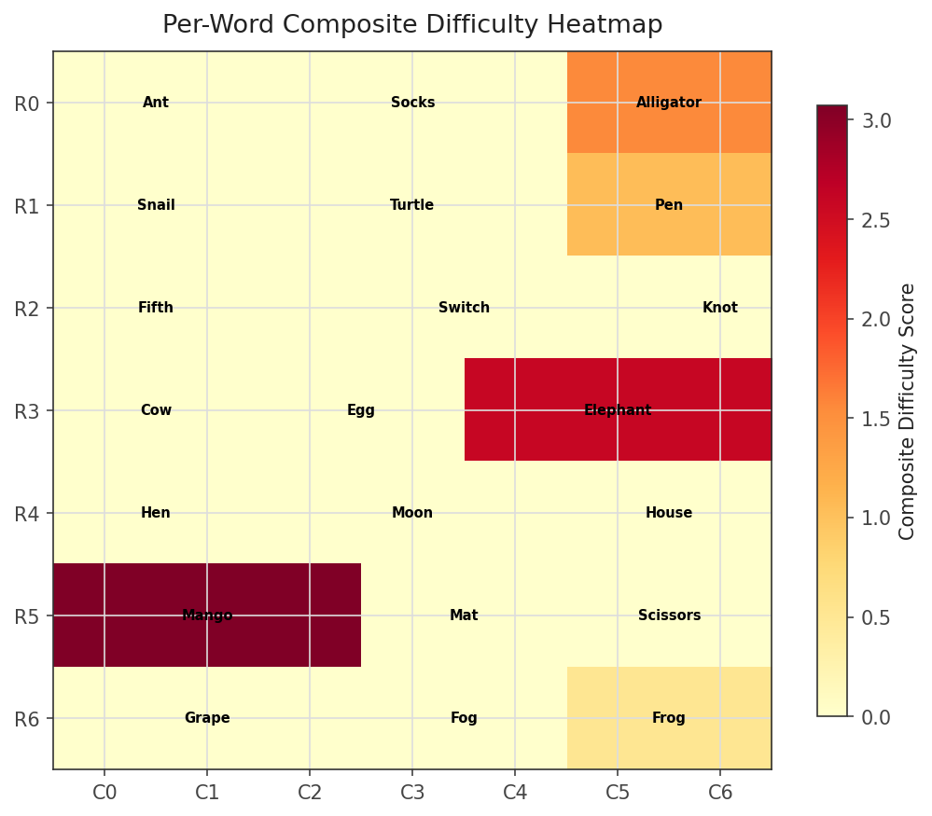
Firmware/RUN2/20260824_001934_difficulty_heatmap.png
