Shreyas-SK-21/Braille-Reading-Analysis-System/Firmware/run2_full_matrix_with backtracking/20260814_211328_velocity_profile.png

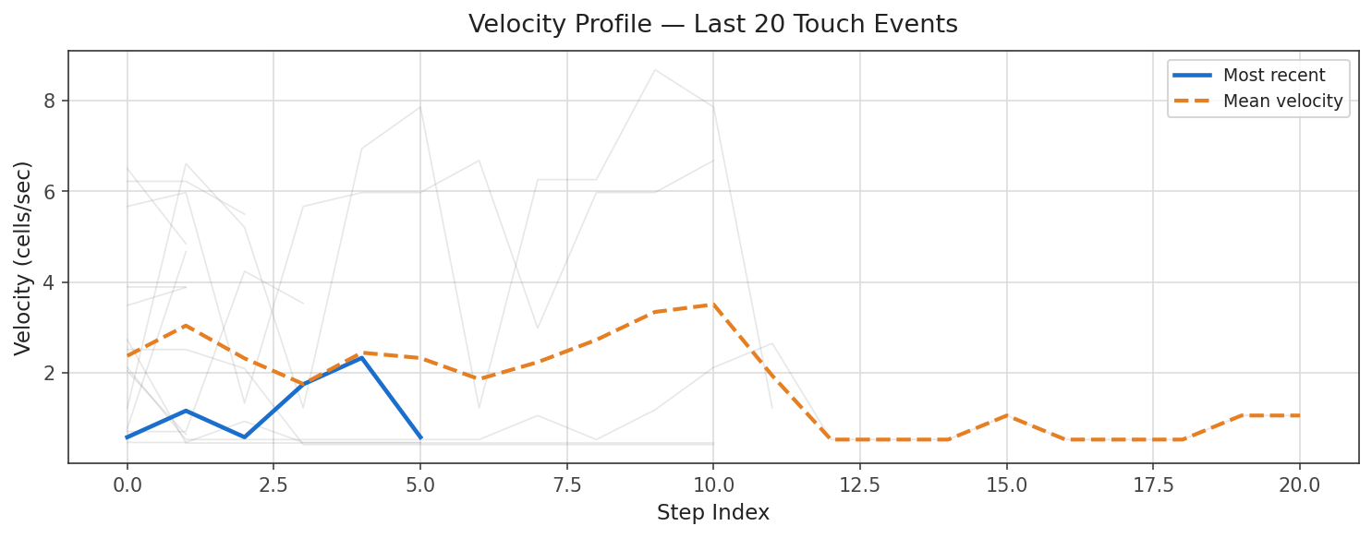
Firmware/run2_full_matrix_with backtracking/20260814_211328_velocity_profile.png
