Shreyas-SK-21/Braille-Reading-Analysis-System/Firmware/run3_random points/20260814_211749_path_efficiency.png

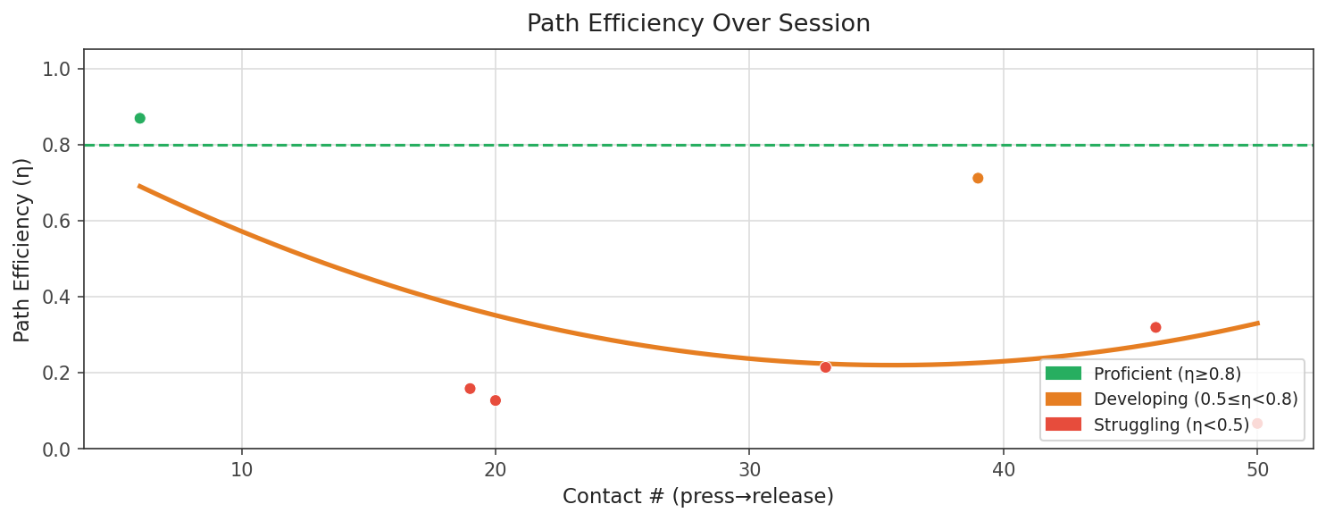
Firmware/run3_random points/20260814_211749_path_efficiency.png
