Shreyas-SK-21/Braille-Reading-Analysis-System/Firmware/run4_full matrix2/20260814_212017_regression_chart.png

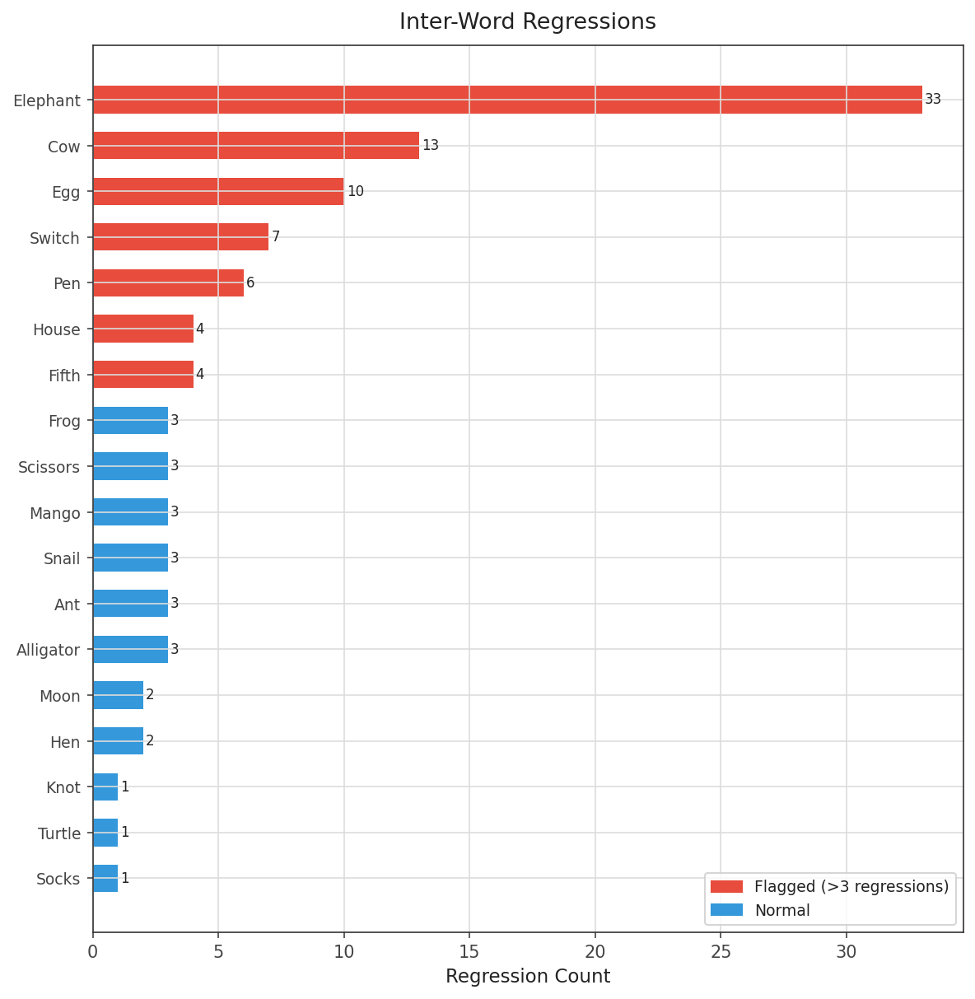
Firmware/run4_full matrix2/20260814_212017_regression_chart.png
