Shreyas-SK-21/Braille-Reading-Analysis-System/Firmware/run5_full matrix_with backtracking/20260814_212418_difficulty_heatmap.png

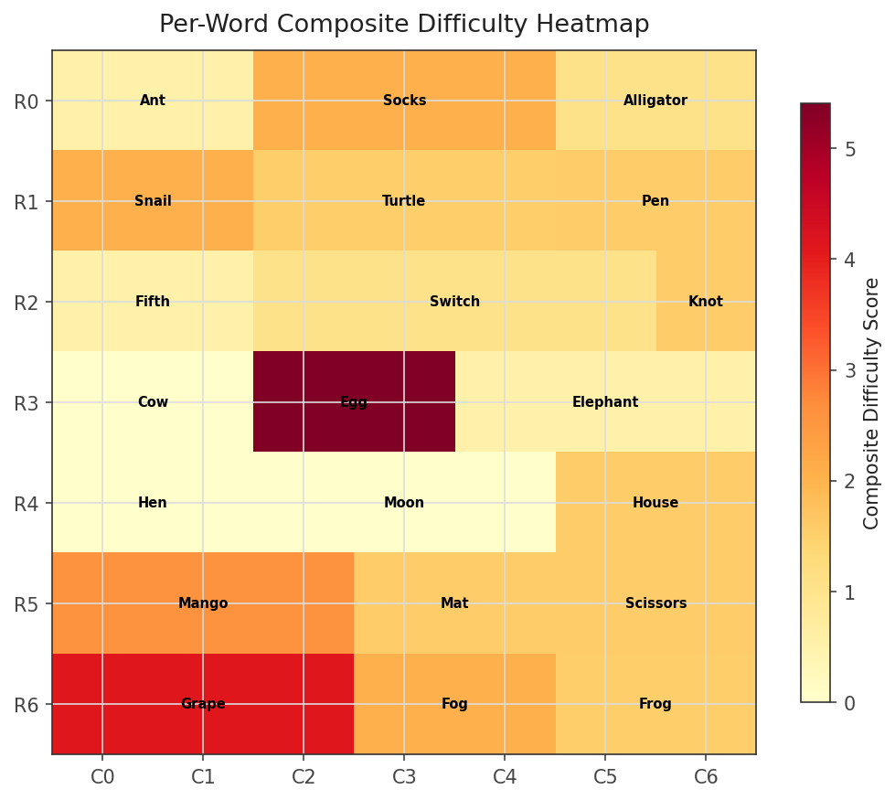
Firmware/run5_full matrix_with backtracking/20260814_212418_difficulty_heatmap.png
