Shreyas-SK-21/Braille-Reading-Analysis-System/Firmware/run6_teest_with_dead_thresholds/20260815_111236_difficulty_heatmap.png

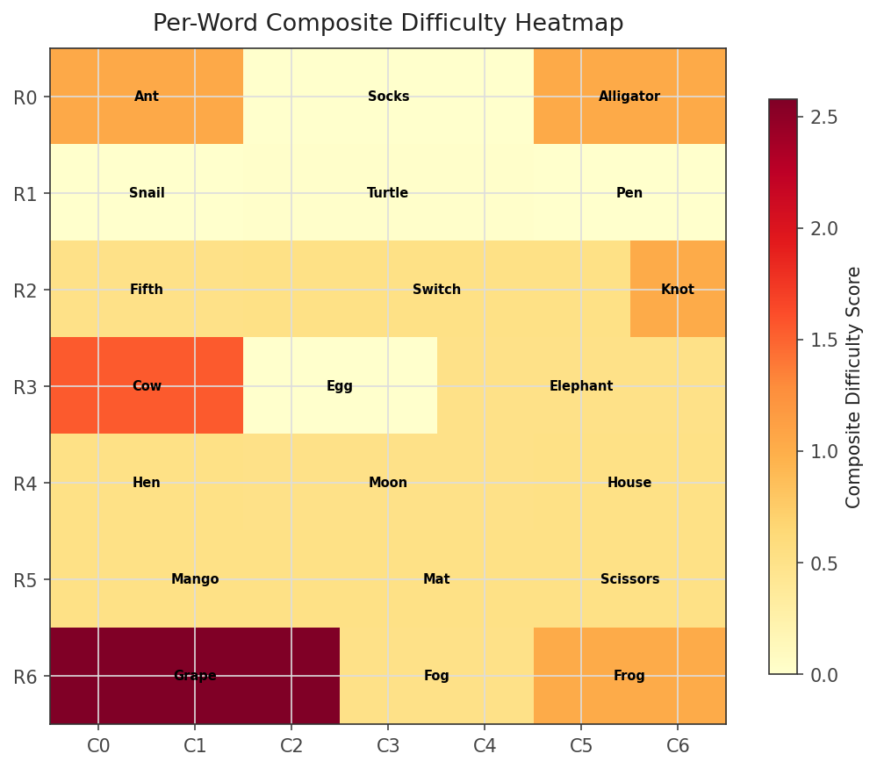
Firmware/run6_teest_with_dead_thresholds/20260815_111236_difficulty_heatmap.png
