Shreyas-SK-21/Braille-Reading-Analysis-System/Firmware/run7/20260815_112634_path_efficiency.png

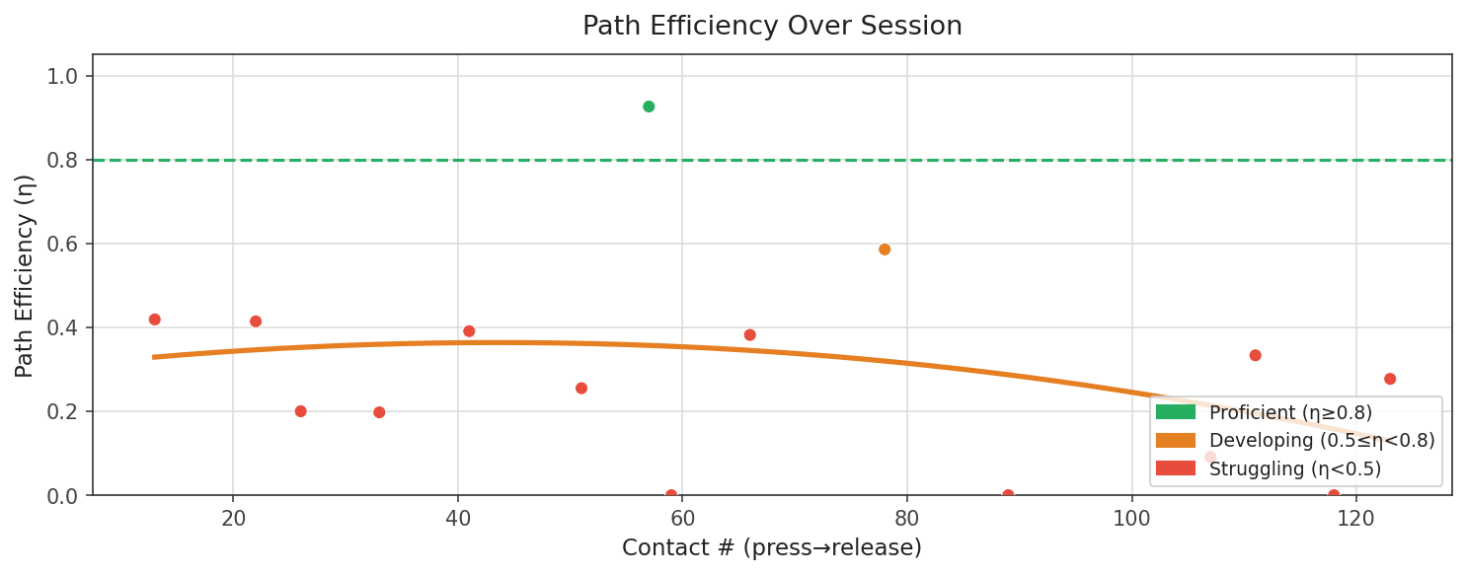
Firmware/run7/20260815_112634_path_efficiency.png
