Shreyas-SK-21/Braille-Reading-Analysis-System/Firmware/run7/20260815_112634_wpm_trend.png

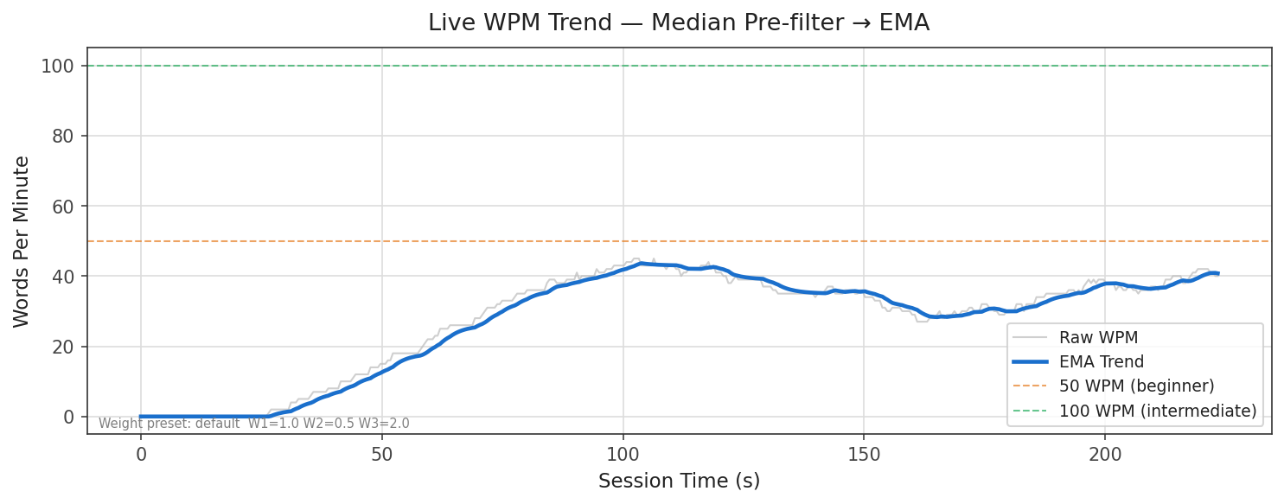
Firmware/run7/20260815_112634_wpm_trend.png
