Shreyas-SK-21/Braille-Reading-Analysis-System/Firmware/session_data/20260824_002559_path_efficiency.png

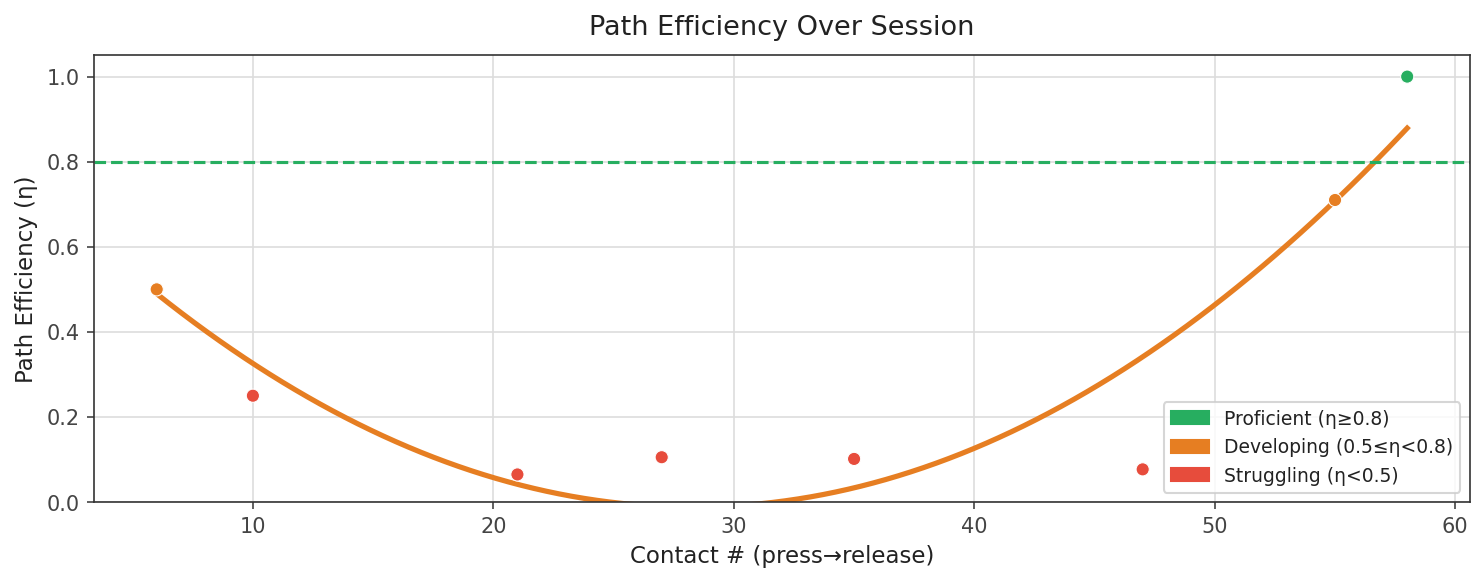
Firmware/session_data/20260824_002559_path_efficiency.png
