Shreyas-SK-21/Braille-Reading-Analysis-System/Firmware/session_data/20260824_002559_velocity_profile.png

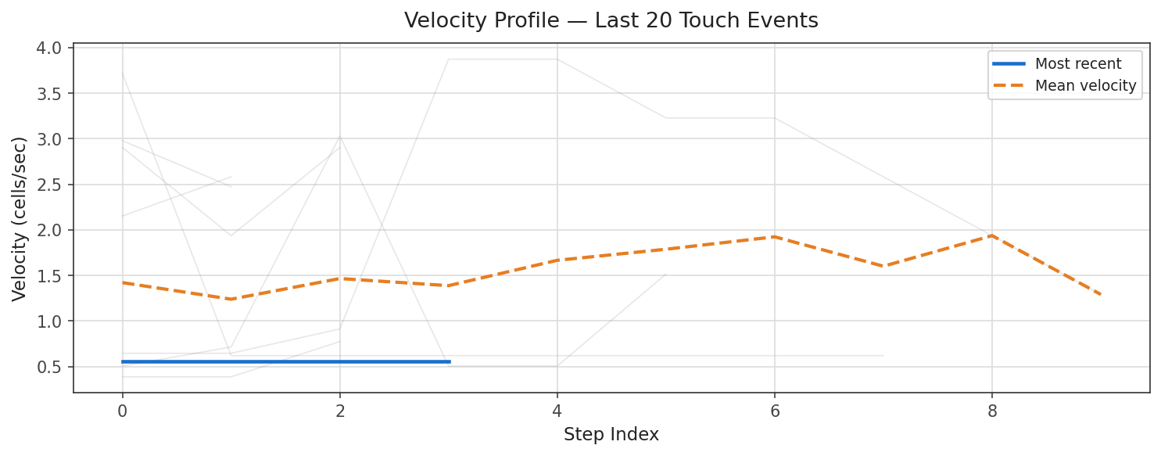
Firmware/session_data/20260824_002559_velocity_profile.png
