Shreyas-SK-21/Braille-Reading-Analysis-System/Papers/Screenshot 2026-05-18 at 12.40.18 PM.png

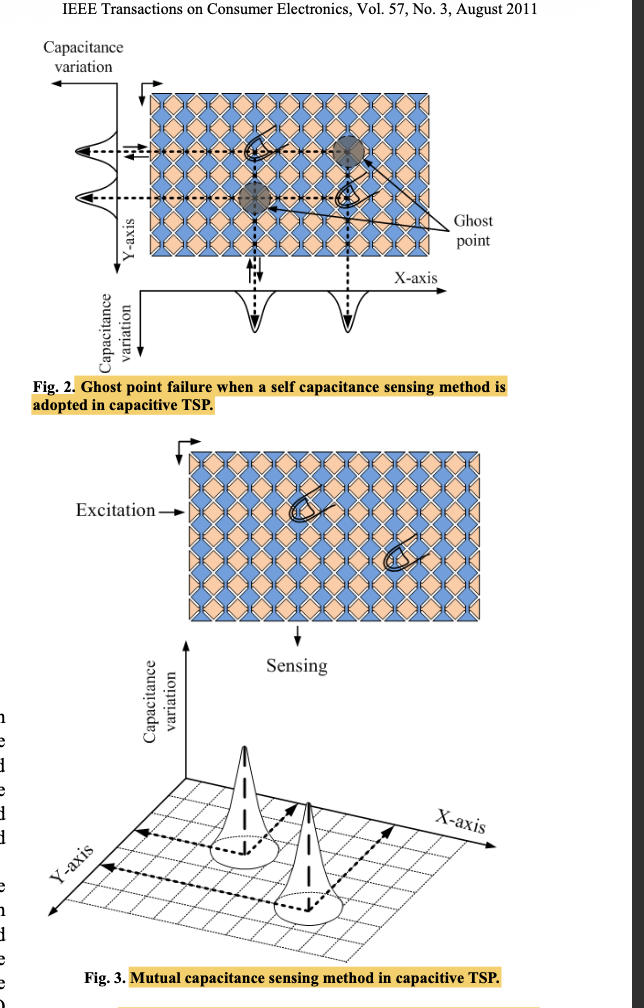
Papers/Screenshot 2026-05-18 at 12.40.18 PM.png
