Shreyas-SK-21/Braille-Reading-Analysis-System/angelina_result.html

 

- Help
- Registration
- РУС
- EN

Sign in Sign in Help

Menu

Set public

Share Send to e-mail Recognize another file

2026-04-19 20:04:41 b11

Recognition result

~?~ .a~?~? ()?a r~?~-aa ~?~ .)-za .j~?~»a?1 ?~?~tw~?~t, -~?~)a w~?~t~?~(~?~~?~~?~a )-»)~?~ ~?~~?~a

⠮⠀⠲⠁⠸⠢⠀⠀⠶⠶⠢⠁⠀⠗⠪⠤⠁⠁⠀⠮⠀⠀⠲⠜⠤⠵⠁⠀⠲⠚⠔⠴⠁⠢⠼⠁⠀⠢⠸⠞⠺⠩⠞⠂⠀⠠⠤⠨⠮⠜⠁⠼⠀⠼⠀⠀⠀⠀⠺⠪⠞⠠⠶⠔⠸⠸⠠⠁⠀⠜⠨⠤⠴⠜⠪⠀⠐⠮⠠⠁

Recognition result

~?~p'z ~?~r?z~?~ ~?~«oo~?~ ~?~; ook ~?~; ooj ~?~wool~?~!or~?~ ~?~noo ~?~k?~?~~?~ ~?~(w'z ~?~(w?z( ~?~)lop~?~~?~v~?~~?~ ~?~«l?~?~( ~?~(!~?~~?~v ~?~~?~r~?~~?~ ~?~~?~xu~?~~?~! ~?~-orz~?~.'u ./r .m?-~?~ ~?~-o'~?~ ~?~/o'~?~ ~?~(o'v d~?~?~?~~?~~?~m~?~~?~~?~~?~«ly ~?~n»; r' ~?~r'?l ~?~z'fl ~?~-!'?z~?~mu; r~?~ll' x; ~?~lu ~?~; rm(! ~?~n'r ~?~-ln-k~?~(rkvg ~?~«o) ~?~«ro( ~?~»olz ~?~»m-, ~?~zm~?~~?~)'z(o ~?~u'~?~ ~?~(-?((or- ~?~»o) ~?~«ro-k ~?~»rmu~?~z~?~z ~?~uooz p!om(~?~ ~?~-ou; ~?~ro(~?~ ~?~r, ; l-~?~~?~-ow ~?~~?~() ~?~~?~l~?~v!'z/ ~?~~?~l; ow ~?~!ez» ~?~»oor~?~«~?~h! ~?~uu(- z ~?~z~?~(~?~ ~?~zo(~?~ ~?~-r'; ~?~-'l~?~(yr-l ~?~~?~mr~?~l~?~ ~?~v~?~z ~?~v'rro~?~ ~?~(!ot( ~?~-~?~o~?~'z~?~ ~?~(o-k( ~?~'l~?~?('~?~or ~?~'vvl~?~ ~?~mz ~?~~?~r~?~~?~

⠿⠿⠿⠀⠈⠏⠄⠵⠀⠈⠗⠢⠵⠘⠀⠈⠦⠕⠕⠳⠀⠈⠆⠕⠕⠅⠀⠈⠆⠕⠕⠚⠀⠈⠺⠕⠕⠇⠈⠖⠕⠗⠠⠀⠈⠝⠕⠕⠀⠈⠅⠢⠳⠔⠀⠈⠣⠺⠄⠵⠀⠈⠣⠺⠢⠵⠶⠀⠈⠶⠇⠕⠏⠔⠈⠧⠻⠔⠀⠈⠦⠇⠢⠔⠣⠀⠈⠣⠖⠔⠔⠧⠀⠈⠳⠗⠔⠔⠀⠈⠳⠭⠥⠔⠳⠖⠀⠈⠤⠕⠗⠵⠈⠲⠄⠥⠀⠲⠌⠗⠀⠲⠍⠢⠤⠔⠀⠈⠤⠕⠄⠳⠀⠈⠌⠕⠄⠳⠀⠡⠣⠕⠄⠧⠀⠙⠳⠢⠔⠈⠳⠍⠳⠳⠔⠮⠦⠇⠽⠀⠈⠝⠴⠆⠗⠄⠀⠈⠗⠄⠢⠇⠀⠈⠵⠄⠋⠇⠀⠈⠤⠖⠄⠢⠵⠈⠍⠥⠆⠗⠹⠇⠇⠄⠀⠭⠆⠔⠇⠥⠀⠈⠆⠗⠍⠣⠖⠀⠈⠝⠄⠗⠀⠈⠤⠇⠝⠤⠅⠈⠶⠗⠅⠧⠛⠀⠈⠦⠕⠶⠀⠈⠦⠗⠕⠶⠀⠈⠴⠕⠇⠵⠀⠈⠴⠍⠤⠂⠀⠈⠵⠍⠳⠈⠶⠄⠵⠶⠕⠀⠈⠥⠄⠳⠀⠈⠣⠤⠢⠣⠣⠕⠗⠤⠀⠈⠴⠕⠶⠀⠈⠦⠗⠕⠤⠅⠀⠈⠴⠗⠍⠥⠈⠵⠔⠵⠀⠈⠥⠕⠕⠵⠀⠏⠖⠕⠍⠣⠔⠀⠈⠤⠕⠥⠆⠀⠈⠗⠕⠣⠔⠀⠈⠗⠂⠆⠇⠤⠳⠈⠤⠕⠺⠀⠈⠔⠶⠶⠀⠈⠔⠇⠔⠧⠖⠄⠵⠌⠀⠈⠔⠇⠆⠕⠺⠀⠈⠖⠑⠵⠴⠀⠈⠴⠕⠕⠗⠈⠦⠱⠓⠖⠀⠈⠥⠥⠣⠤⠿⠀⠵⠀⠈⠵⠔⠣⠳⠀⠈⠵⠕⠣⠔⠀⠈⠤⠗⠄⠆⠀⠪⠤⠄⠇⠈⠣⠽⠗⠤⠇⠀⠈⠳⠍⠗⠳⠇⠔⠀⠈⠧⠔⠵⠀⠈⠧⠄⠗⠗⠕⠳⠀⠈⠣⠖⠕⠞⠣⠀⠈⠤⠔⠕⠈⠄⠵⠻⠀⠈⠣⠕⠤⠅⠣⠀⠈⠄⠇⠫⠢⠶⠄⠳⠕⠗⠀⠈⠄⠧⠧⠇⠔⠀⠈⠼⠍⠵⠀⠈⠳⠗⠔⠔

## About the project

The "Angelina Braille Reader" by Ilya Ovodov is a non-profit project designed to simplify the reading of Braille texts by sighted people: teachers, relatives, friends of blind people. To read the text in Braille, just take a picture of it and upload it to the program. The project is being developed as free and open source software. If you are a programmer and want to help the project — join us (https://github.com/IlyaOvodov/AngelinaReader/issues)

- Main
- Help

For suggestions and comments: admin@angelina-reader.com

Help with development: GitHub (https://github.com/IlyaOvodov/AngelinaReader/issues)

© 2021 Angelina braille reader. All rights reserved.

Supported by Presidential Grants Foundation

100%

+

### New user registration

To register, confirm that you:

you've got acquainted with how to take a photo properly

you agree to the terms and conditions of privacy agreement

Are you sure you are not a robot? Give an answer (as digits):
How much is 4 + 10 ?

Register

Login e-mail:

### Change password

Update password

### User name

### User default setting

### Publicity agreement

### Recognition defaults

Text language

Auto-orientation

Both sides

### E-mail and sharing defaults

Image

Text

Braille text

Braille text format:

Unicode

ASCII (BRF)

Update

Additionally:

Completely delete the account

### Restore Password

Are you sure you are not a robot? Give an answer (as digits):
How much is 4 + 10 ?

Recover

### Send To E-mail

Only registered users can send e-mails

to prevent bad guys from spam distribution throught the application

### Share results

What to send?

Image

Text

Braille text

!

Specify at least one file type

Keep in mind that if you select multiple types of results at the same time, different selected applications may react differently. Learn more...

Title

Share

### Login

Registration Forgot your password

Login

### You did not log in

When working without authorization, you will not be able to

- view recognition results later,
- share them with other users,
- use some other features.

We recommend register and log in. It's free.

Proceed Cancel
