Shreyas-SK-21/Braille-Reading-Analysis-System/Firmware/braille_ui.py

"""
Braille Touch Performance Monitor
==================================
Reads a 7x7 capacitive matrix from ESP32 over serial and quantifies
a reader's Braille performance in real-time.

Hardware notes
--------------
* ESP32 drives TX rows via a 3-bit mux (pins 4,5,18 → S0,S1,S2)
* RX columns are read on ADC pins [32,33,34,35,25,36,39]
* Serial output: 7 rows × 7 tab-separated ADC values, blank line separator
* TX_SHIFT corrects mux wiring in detection logic ONLY.
  The heatmap always shows the raw matrix layout so touching physical
  cell (row=0, col=0) always glows at the top-left of the display.

FIXES vs previous version
--------------------------
1. text_grid normalised to exactly GRID (7) words per row so every column
   maps to exactly one word with no fractional/overlapping boundaries.
2. _build_word_boundaries rewritten to use integer column-range slicing
   (numpy-style) so boundaries never overlap or leave gaps.
3. TX_SHIFT application audited end-to-end:
   - Detection / metrics:  map_tx_col() applied once, consistently.
   - Heatmap label cache:  same map_tx_col() applied, coord string shows
                           logical col so display matches side-panel.
   - word_stats.register() receives already-corrected logical coords.
4. CAL_FRAMES raised to 30 for a stable baseline.
5. WordBoundaryEditor._apply() no longer re-imports from the stale
   text_grid constant for extra rows; it uses the live word_boundaries.
6. count_backtracks, difficulty helpers unchanged (were correct).
7. Minor: removed duplicate 'Tree' in row 0 text_grid entry.

8. [KEY FIX] Mid-touch slide detection:
   - PeakLock.update() now returns (locked_cell, jumped: bool).
   - A confirmed jump >= NEW_BLOCK_JUMP_THRESHOLD cells (Manhattan)
     finalises the current TouchEvent and immediately starts a new one
     at the new cell — without requiring a lift-off between blocks.
   - live_word display is driven from the RAW analysis peak (no lock lag)
     so the "Word now" panel updates instantly when finger moves.

9. [WPM FIX] Sliding Window WPM Counter (O(1) circular bucket algorithm):
   - Replaces the naive deque-scan WPM calculation in PerformanceMetrics.
   - SlidingWindowWPM uses 60 integer buckets (one per second) arranged
     as a circular buffer. A running total is maintained so get_wpm()
     costs exactly one integer read — no loops, no eviction scans.
   - record_touch() is called inside metrics_thread every time a
     TouchEvent is finalised, giving true per-word WPM tracking.
   - Memory is fixed at 60 integers regardless of reading speed.
   - All other PerformanceMetrics fields (duration, efficiency, etc.)
     are unchanged; only the wpm field now comes from SlidingWindowWPM.

10. [M-H1] Seen-Set Regression Tracker:
    - WordStatsTracker now maintains a `seen` set for O(1) session-scoped
      regression detection.
    - `regression_count` maps word → regression hit count.
    - `total_regressions` is a running integer counter.
    - register() performs a single hash-set membership check per touch:
        * Word already in seen → regression; increment counters.
        * Word not in seen    → first touch; insert into seen.
    - snapshot() now exposes:
        * hesitation_rate  = total_regressions / total_touches
        * top_regressed    = top-5 words by regression count
        * flagged_words    = words with regression_count > REGRESSION_FLAG_THRESHOLD
    - Memory: O(V) where V = unique vocabulary, regardless of total touches.
    - Thread safety: all mutations guarded by the existing self._lock.
    - UI: regression metrics surfaced in the Word Stats panel and a new
      Regression Alerts section below the top-words list.

11. [M-D2] EWIQR Per-Word Difficulty Tracker:
     - EWIQRPerWordTracker maintains a sorted window of (duration, weight)
       pairs per word with exponential decay (lambda=0.85) per new touch.
     - Computes weighted Q1/Q3/IQR to answer: "which cells are genuinely
       hard right now?" -- robust to frequency, outliers, and bimodality.
     - WelfordPerWord provides session-wide per-word n/mean/std bookkeeping.
     - snapshot() produces: ewiqr_per_word, Q1/Q3, confidence, top5_hardest,
       session_avg, and a 7x7 masked Z_tot difficulty surface.
     - Cold start returns null until min_window (5) touches per word.
     - Thread safety: per-word locking via the tracker's self._lock.

12. [M-D3] Skip Statistics Engine:
     - Layer 1: Single-Pass Accumulator sweeps word_boundaries once,
       producing skip_rate, skipped_words, partially_visited_rows,
       and a 7×7 boolean skip_mask — all from one dict lookup per cell.
       Stale keys in word_count are structurally unreachable.
     - Layer 2: BFS Cluster Analysis takes skip_mask as sole input.
       Finds 4-connected components of skipped cells, classifies each
       by bounding-box geometry: row_sweep_failure, column_alignment,
       boundary_avoidance, saccade_drift, singleton_noise, scattered_gap.
       Clusters < 4 cells suppressed as noise. Runs at session end only.

13. [V-4] Median Pre-filter → EMA Live WPM Trend:
      - Two-stage noise separation pipeline for live WPM monitoring.
      - Stage 1: Median pre-filter (window=3) kills impulsive spikes
        (hesitation, stumbles) via 50% breakdown point.  Isolated
        outliers are absorbed; sustained slowdowns pass through.
      - Stage 2: EMA (α=0.15) smooths residual variance.  Half-life
        ~0.9s at 5fps — fast enough for flow-state feedback, slow
        enough to ignore sub-second stumbles.
      - WPMTrendTracker.on_frame() is called in metrics_thread at 5fps.
      - get_plot_data() recomputes the full EMA series from raw buffer
        with the median pre-filter applied for plot-line correctness.
      - Separate matplotlib figure shows raw WPM (faded) and EMA trend
        (bright green) with auto-scaling axes.  Updated at ~2fps.
      - Thread safety: all state guarded by self._lock.

14. [V-5] Inter-Word Regression Bar Chart:
      - Horizontal bar chart showing which words the reader regresses
        to most, driven from WordStatsTracker regression_count.
      - Two-layer architecture at different frequencies:
        Layer 1 (60fps): Copies regression snapshot, checks 500ms throttle.
        Layer 2 (2fps):  Full cla() redraw — filter → sort → colour →
        clear → empty guard → barh() → annotations → draw_idle().
      - cla() clears only the axes content, leaving the GridSpec slot
        intact.  Adjacent panels (heatmap, text) are untouched.
      - Bars are red for flagged words (>REGRESSION_FLAG_THRESHOLD),
        blue otherwise.  Colour assignment runs fresh every redraw.
      - Annotations placed inside the bar for long bars, outside for
        short bars, to avoid text overflow.
      - Total cost at 20 bars ≈ 5ms; budget at 2fps = 500ms (1%).
      - Thread safety: snapshot is a cheap dict copy from the UI loop.

15. [V-6] 3D Surface Monitor:
      - Interactive 3D surface plot (matplotlib Axes3D) visualising
        per-cell metrics on a 7×7 meshgrid.
      - Two selectable Z-surfaces via RadioButtons widget:
          * Time-on-Task: mean touch duration per word from Welford tracker
          * Mean Difficulty: EWIQR difficulty score per word
      - Surface replacement algorithm removes only the PolyCollection
        artist, preserving the Axes3D object, wireframe overlay, base
        labels, and view angle across toggles.
      - Throttled at 2fps (0.5s interval) to avoid overloading the
        matplotlib rendering pipeline.
      - Base-plane labels (Z=0) show the word grid for spatial reference.

16. [V-7] Velocity Profile Overlay:
       - Overlays the last 20 touch-event velocity arrays on a single
         axes, with the most recent event drawn bold blue, past events
         as faint gray lines, and an exponentially weighted mean as an
         orange dashed line.
       - Exponential decay (alpha=0.15) ensures recent events dominate
         the mean while older events fade gracefully.
       - on_frame() is called in _finalise_touch() with each new
         velocity array; update throttled at 5fps (0.2s interval).
       - Auto-scales Y to max velocity × 1.1 across all stored events.

17. [V-8] Path Efficiency Plot:
       - Colour-coded scatter plot of per-event path efficiency
         (η = straight_line / path_length) with a LOWESS trend line.
       - Three efficiency tiers: green (η≥0.8 proficient), orange
         (0.5≤η<0.8 developing), red (η<0.5 struggling).
       - LOWESS trend recomputed every 10 events; falls back to
         degree-2 polynomial if statsmodels is not installed.
       - Proficiency target reference line at η=0.8.
       - Throttled at 2fps (0.5s interval).
       - on_event_recorded() called in _finalise_touch() with each
         event's path efficiency value.
"""

import sys
import serial
import numpy as np
from typing import Optional
import threading
import queue
import time
from collections import deque, defaultdict
import bisect
import warnings
warnings.filterwarnings("ignore")

# ─── Weight preset CLI flag ──────────────────────────────────
_PRESET = next((a for a in sys.argv if a.startswith("--weight-preset=")), None)
_WEIGHT_PRESET = _PRESET.split("=", 1)[1] if _PRESET else "default"
# Presets: default | speed_focused | accuracy_focused
# default:          W1=1.0 W2=0.5 W3=2.0 (original)
# speed_focused:    W1=0.5 W2=0.3 W3=3.0 (penalise slow more)
# accuracy_focused: W1=2.0 W2=1.0 W3=1.0 (penalise reversals/jitter more)
_PRESET_MAP = {
    "default":          (1.0, 0.5, 2.0),
    "speed_focused":    (0.5, 0.3, 3.0),
    "accuracy_focused": (2.0, 1.0, 1.0),
}
if _WEIGHT_PRESET not in _PRESET_MAP:
    print(f"[WARNING] Unknown weight preset '{_WEIGHT_PRESET}', using 'default'.")
    _WEIGHT_PRESET = "default"

# ═══════════════════════════ MODE FLAGS ════════════════════════
# --legacy    : use the original Matplotlib/Tkinter UI.
# --sweep-mode: hardware calibration sweep — disables regression
#               counter, shows 7×7 coverage grid instead.
_LEGACY_MODE = "--legacy" in sys.argv
SWEEP_MODE   = "--sweep-mode" in sys.argv
if SWEEP_MODE:
    print("[CONFIG] Sweep mode ACTIVE — regression counter disabled, coverage grid shown.")

if _LEGACY_MODE:
    import matplotlib
    matplotlib.use("TkAgg")
    import matplotlib.pyplot as plt
    import matplotlib.gridspec as gridspec
    from matplotlib.colors import LinearSegmentedColormap
    import matplotlib.widgets as mwidgets
    from matplotlib.widgets import RadioButtons
    from mpl_toolkits.mplot3d import Axes3D  # noqa: F401
    import tkinter as tk
    from tkinter import ttk, messagebox
else:
    # ── Headless matplotlib for class definitions that reference it ──
    import matplotlib
    matplotlib.use("Agg")
    import matplotlib.pyplot as plt
    import matplotlib.gridspec as gridspec
    from matplotlib.colors import LinearSegmentedColormap
    import matplotlib.widgets as mwidgets
    from matplotlib.widgets import RadioButtons
    # ── PyQtGraph + PyQt5 ──
    import pyqtgraph as pg
    from PyQt5 import QtWidgets, QtCore, QtGui
    from PyQt5.QtWidgets import (
        QMainWindow, QWidget, QVBoxLayout, QHBoxLayout, QGridLayout,
        QLabel, QSlider, QPushButton, QDialog, QScrollArea, QSpinBox,
        QLineEdit, QStackedWidget, QListWidget, QListWidgetItem,
        QMessageBox, QSplitter, QFrame, QApplication, QGroupBox,
        QTableWidget, QTableWidgetItem, QHeaderView,
    )
    from PyQt5.QtCore import Qt, QTimer
    from PyQt5.QtGui import QFont, QColor, QPalette

# ═══════════════════════════ CONFIG ═══════════════════════════
PORT        = "COM5"   # adjust for your OS
BAUD        = 115200
GRID        = 7
CAL_FRAMES  = 10

# Wiring correction applied in detection logic only (NOT in heatmap display)
TX_SHIFT    = -1          # logical_col = (raw_col + TX_SHIFT) % GRID

# Per-row ADC-delta thresholds — tune until idle noise stays below them
ROW_THRESHOLDS = np.array([50, 50, 50, 50, 50, 50, 50], dtype=float)

# Re-trigger dead-time: minimum seconds before the SAME cell can register
# a new touch event. Derived from 5-run CSV analysis: false re-triggers
# during a sustained ~1600ms hold occur every ~300ms on average, so 400ms
# suppresses all in-hold phantom events while still allowing genuine
# intentional revisits (backtracking users return after >500ms away).
RETRIGGER_DEAD_TIME_S = 0.40

MIN_PRESSED_CELLS    = 1
BOLD_PEAK_POWER      = 2.0

# EMA alpha = fraction of NEW data blended per frame
DETECT_SMOOTH_ALPHA  = 0.90     # ↑ from 0.80 — less smoothing lag, faster response
PEAK_HISTORY_LEN     = 1        # ↓ from 2 — lock resolves cell in 1 consistent frame

# Wobble filter: movements <= this many cells are ignored inside a block
MAX_ACCEPTABLE_JUMP  = 1

# Slide detector: a confirmed jump >= this triggers a NEW touch event
# without needing a lift-off. Set to 2 so a 1-cell wobble is absorbed
# but any real slide to a different block registers immediately.
NEW_BLOCK_JUMP_THRESHOLD = 2

RELEASE_FRAMES_NEEDED = 2       # ↓ from 4 — 100ms post-touch silence (was 200ms at 20fps)
MAX_TOUCH_DURATION_S  = 10.0   # force-finalise any touch stuck longer than this

ROLL_WINDOW     = 60
UI_FPS          = 30            # ↑ from 20 — ~33ms/frame (was 50ms), 17ms less display lag
FRAME_QUEUE_MAX = 1

# ── Difficulty Score weights (set by --weight-preset flag) ────
W1, W2, W3 = _PRESET_MAP[_WEIGHT_PRESET]
_WEIGHT_NOTE = f"Weight preset: {_WEIGHT_PRESET}  W1={W1} W2={W2} W3={W3}"
print(f"[CONFIG] {_WEIGHT_NOTE}")

# ── M-H1: Regression flag threshold ──────────────────────────
# Words touched more than this many times as regressions are "flagged"
REGRESSION_FLAG_THRESHOLD = 3

# ── M-H1: Time-windowed regression ───────────────────────────
# A touch only counts as a regression if the same word was already
# touched within this many seconds. Prevents false regressions in
# long sessions or multi-pass sweeps (e.g. row sweep over 2+ min).
# Set to None to use the original session-lifetime seen-set behaviour.
REGRESSION_WINDOW_S = 30.0   # seconds

# ── M-D2: EWIQR per-word difficulty tracker ──────────────────
EWIQR_D2_LAMBDA       = 0.85   # decay factor per new touch (≠ velocity λ)
EWIQR_D2_WEIGHT_FLOOR = 0.01   # prune threshold
EWIQR_D2_MIN_WINDOW   = 3      # ↓ from 5 — show data after 3 touches/word

# ── V-4: Median Pre-filter → EMA WPM trend ────────────────────
WPM_TREND_ALPHA           = 0.15    # EMA blend ratio (higher = more responsive)
WPM_TREND_MEDIAN_WINDOW   = 3       # pre-filter window (odd; absorbs 1 outlier)
WPM_TREND_BUFFER_MAXLEN   = 720     # raw buffer capacity (120s × 6fps)
WPM_TREND_UPDATE_INTERVAL = 0.2     # seconds (5fps sampling inside 60fps loop)

# ── V-5: Inter-Word Regression Bar Chart ───────────────────────
REGRESSION_CHART_UPDATE_INTERVAL = 0.5   # seconds — chart updates at ~2fps

# ── V-6: 3D Surface Monitor ───────────────────────────────────
SURFACE_3D_UPDATE_INTERVAL = 0.5         # seconds — 2fps throttle

# ── V-7: Velocity Profile Overlay ─────────────────────────────
VEL_PROFILE_N_OVERLAY       = 20         # how many events to overlay
VEL_PROFILE_ALPHA_WEIGHT    = 0.15       # exponential decay factor for weighted mean
VEL_PROFILE_UPDATE_INTERVAL = 0.2        # seconds — 5fps throttle

# ── V-8: Path Efficiency Plot ─────────────────────────────────
EFFICIENCY_LOWESS_RECOMPUTE_INTERVAL = 10   # events between LOWESS recomputes
EFFICIENCY_PLOT_UPDATE_INTERVAL      = 0.5  # seconds — 2fps throttle
EFFICIENCY_LOWESS_FRAC               = 0.3  # LOWESS local window fraction
# ══════════════════════════════════════════════════════════════

# ═══════════════════════ UI THEME ═════════════════════════════
_BG_DARK       = "#0d1117"   # main background
_BG_CARD       = "#161b22"   # card/axes background
_BG_BORDER     = "#30363d"   # card borders
_FG_PRIMARY    = "#e6edf3"   # bright text
_FG_MUTED      = "#8b949e"   # muted text
_ACCENT_BLUE   = "#58a6ff"   # speed metrics
_ACCENT_GREEN  = "#3fb950"   # accuracy/good
_ACCENT_ORANGE = "#f0883e"   # difficulty/warning
_ACCENT_RED    = "#f85149"   # errors/danger
_GRID_COLOR    = "#21262d"   # grid lines

# ── Bill of Materials — cost breakdown (validates 'low-cost' claim) ──────
HARDWARE_COST_USD = {
    "ESP32 dev board":          4.00,   # e.g. ESP32-WROOM-38-pin
    "Copper tape (1m roll)":    2.50,   # conductive grid electrodes
    "Multiplexer IC (2x CD4051)": 0.80, # 8:1 analog mux for rows+cols
    "Resistors + capacitors":   0.30,   # passive components
    "USB cable":                0.50,
    "Braille overlay sheet":    1.00,   # printed or embossed
    "PCB / perfboard":          1.50,   # optional; breadboard = $0
    "Misc (wire, headers)": 0.50,
}
_TOTAL_COST_USD = sum(HARDWARE_COST_USD.values())
print(f"[CONFIG] Estimated hardware cost: ${_TOTAL_COST_USD:.2f} USD")
print(f"[CONFIG] BOM: {list(HARDWARE_COST_USD.keys())}")

# Font stack — first available is used
if _LEGACY_MODE:
    plt.rcParams['font.family'] = ['Inter', 'Segoe UI', 'SF Pro Display',
                                    'Helvetica Neue', 'sans-serif']

# Active finger view for plot menu: 0 = finger 0, 1 = finger 1, 2 = combined
_active_finger_view = 2
# ══════════════════════════════════════════════════════════════

# ═══════════════════════ WORD MAPPING ═════════════════════════
#
# Each entry is a (word_label, num_blocks) tuple.
#   word_label  = the word name displayed and used for metrics
#   num_blocks  = how many sensor columns this word's copper tape spans
#
# Per-row rule: the num_blocks values MUST sum to GRID (7).
#
# Setting all widths to 1 gives backward-compatible single-block
# per-word behavior.  Increase width to match the physical braille
# sheet copper-tape layout.
#
# Examples:
#   3 words:  [("Ant", 3), ("Apple", 2), ("Star", 2)]      → 3+2+2 = 7
#   2 words:  [("Snail", 4), ("Boat", 3)]                   → 4+3   = 7
#   7 words:  all (word, 1)                                  → 1×7   = 7

text_grid = [
    # (word, num_blocks)  — num_blocks per row must sum to GRID (7)
    [("Ant", 2),    ("Socks", 3),  ("Alligator", 2)  ],  # row 0
    [("Snail", 2),  ("Turtle", 3), ("Pen", 2)   ],  # row 1
    [("Fifth", 2),  ("Switch", 4), ("Knot", 1)    ],  # row 2
    [("Cow", 2),    ("Egg", 2),    ("Elephant", 3)   ],  # row 3
    [("Hen", 2),    ("Moon", 3),   ("House", 2)   ],  # row 4
    [("Mango", 3),  ("Mat", 2),    ("Scissors", 2)   ],  # row 5
    [("Grape", 3),  ("Fog", 2),    ("Frog", 2)],  # row 6
]

# ══════════════════════════════════════════════════════════════
# M-T2: EWIQR VELOCITY CONSISTENCY TRACKER
# ══════════════════════════════════════════════════════════════
#
# Algorithm: Exponentially Weighted IQR (EWIQR)
#
# Each touch event contributes a velocity array (cells/s between
# consecutive sensor cells).  Values are stored with a weight that
# decays by λ per event so recent events dominate without a hard
# cliff.  IQR is computed as a weighted percentile difference
# (P75 − P25).  A consistency score 1 − IQR/mean maps the spread
# onto [0, 1] where 1 = perfectly uniform speed.
#
# Complexity
# ──────────
# record()   : O(T log T) where T = stored value count (bounded by
#              pruning + effective horizon K × N_eff)
# snapshot() : O(1) — reads only the pre-computed cache; never
#              blocks the UI thread on a sort.
# Memory     : O(N_eff × K), fixed; independent of session length.
#
# Hyperparameter
# ──────────────
# λ (EWIQR_LAMBDA) ∈ (0,1).  Effective memory horizon:
#   N_eff ≈ 1 / (1 − λ)
# λ=0.95 → ~20 events dominate.  λ=0.98 → ~50 events.

EWIQR_LAMBDA     = 0.95   # decay factor — tune for faster/slower memory
EWIQR_PRUNE_THR  = 1e-6   # normalized weight below which a value is dropped
EWIQR_RENORM_INT = 50     # renormalize every N events for float stability
EWIQR_MEAN_FLOOR = 0.5    # ε-floor on mean to protect slow/consistent readers


class VelocityTracker:
    """
    M-T2: Thread-safe EWIQR velocity consistency tracker.

    Usage
    ─────
    velocity_tracker.record(vels)    # called in _finalise_touch()
    snap = velocity_tracker.snapshot()
    # snap keys: mean_vel, iqr, consistency, n_events
    """

    def __init__(self, lam: float = EWIQR_LAMBDA):
        self._lam              = lam
        self._values: list     = []   # [[velocity: float, weight: float], …]
        self._decay_acc: float = 1.0  # global aging multiplier
        self._event_count: int = 0
        self._lock             = threading.Lock()
        self._cache: dict      = dict(mean_vel=0.0, iqr=0.0,
                                      consistency=0.0, n_events=0)

    # ── public API ────────────────────────────────────────────

    def record(self, velocity_array: np.ndarray) -> None:
        """
        Register one touch event's velocity array and recompute stats.

        Steps (all performed with lock held):
          1. Multiply decay_accumulator by λ  → ages all existing weights
             without touching them individually (O(1) aging trick).
          2. Append each new velocity with effective_weight = 1/decay_acc
             so incoming values appear at weight 1 in the decayed frame.
          3. Prune values whose normalized weight drops below EWIQR_PRUNE_THR.
          4. Every EWIQR_RENORM_INT events, divide all weights by max_weight
             and reset decay_acc to 1.0 — prevents float overflow/underflow.
          5. Recompute and cache stats atomically.
        """
        if len(velocity_array) == 0:
            return

        with self._lock:
            # Step 1: age existing weights
            self._decay_acc *= self._lam

            # Step 2: insert new values
            ew = 1.0 / self._decay_acc
            for v in velocity_array:
                self._values.append([float(v), ew])

            # Step 3: prune negligible-weight values
            if self._values:
                total_w = sum(row[1] for row in self._values)
                if total_w > 0:
                    self._values = [
                        row for row in self._values
                        if row[1] / total_w > EWIQR_PRUNE_THR
                    ]

            self._event_count += 1

            # Step 4: periodic renormalization for numerical stability
            if self._event_count % EWIQR_RENORM_INT == 0 and self._values:
                max_w = max(row[1] for row in self._values)
                if max_w > 0:
                    for row in self._values:
                        row[1] /= max_w
                    self._decay_acc = 1.0

            # Step 5: recompute + atomically replace cache
            self._cache = self._compute_stats()

    def snapshot(self) -> dict:
        """
        Return a copy of the pre-computed stats cache.
        O(1) — the UI thread is never blocked by a sort.
        """
        with self._lock:
            return dict(self._cache)

    def reset(self) -> None:
        with self._lock:
            self._values      = []
            self._decay_acc   = 1.0
            self._event_count = 0
            self._cache       = dict(mean_vel=0.0, iqr=0.0,
                                     consistency=0.0, n_events=0)

    # ── internal ─────────────────────────────────────────────

    def _compute_stats(self) -> dict:
        """
        Compute weighted mean, IQR, and consistency score.
        Must be called with self._lock held.

        Percentile method: sort by value, walk cumulative normalized
        weight, record value when cumsum first crosses 0.25 and 0.75.
        Uses np.searchsorted for efficiency.
        """
        EMPTY = dict(mean_vel=0.0, iqr=0.0, consistency=0.0,
                     n_events=self._event_count)
        if not self._values:
            return EMPTY

        vals    = np.array([row[0] for row in self._values], dtype=float)
        weights = np.array([row[1] for row in self._values], dtype=float)

        total        = weights.sum()
        norm_weights = weights / total

        # Weighted mean
        mean_vel = float(np.dot(vals, norm_weights))

        # Weighted percentiles via sorted cumulative walk
        order       = np.argsort(vals)
        sorted_vals = vals[order]
        sorted_w    = norm_weights[order]
        cumsum      = np.cumsum(sorted_w)

        p25_idx = int(np.searchsorted(cumsum, 0.25))
        p75_idx = int(np.searchsorted(cumsum, 0.75))
        p25_idx = min(p25_idx, len(sorted_vals) - 1)
        p75_idx = min(p75_idx, len(sorted_vals) - 1)

        p25 = float(sorted_vals[p25_idx])
        p75 = float(sorted_vals[p75_idx])
        iqr = p75 - p25

        # Consistency score — floor mean at ε to protect slow readers
        consistency = 1.0 - (iqr / max(mean_vel, EWIQR_MEAN_FLOOR))
        consistency = float(np.clip(consistency, 0.0, 1.0))

        return dict(
            mean_vel    = mean_vel,
            iqr         = iqr,
            consistency = consistency,
            n_events    = self._event_count,
        )

def _build_word_boundaries(tgrid: list, total_cols: int) -> dict:
    """
    Returns {row_idx: [{"word", "start", "end"}, …]} where start/end
    are inclusive column indices, covering 0 … total_cols-1 with no
    gaps or overlaps.

    Supports two entry formats per row:
      - (word_label, num_blocks) tuple → explicit width
      - plain string                   → width = 1 (legacy)

    The num_blocks values per row MUST sum to total_cols.
    """
    boundaries: dict = {}
    for row_idx, row in enumerate(tgrid):
        entries = []
        col = 0
        for item in row:
            if isinstance(item, (tuple, list)):
                word, width = item[0], int(item[1])
            else:
                # Legacy plain-string format → single-block word
                word, width = item, 1
            entries.append({
                "word":  word,
                "start": col,
                "end":   col + width - 1,
            })
            col += width
        if col != total_cols:
            print(f"WARNING: Row {row_idx} block widths sum to {col}, "
                  f"expected {total_cols}. Boundary mapping may be incorrect.")
        boundaries[row_idx] = entries
    return boundaries


# Global mutable boundary table — edited live by the word editor.
word_boundaries_lock = threading.Lock()
word_boundaries = _build_word_boundaries(text_grid, GRID)


def get_word_from_touch(row: int, col: int) -> Optional[str]:
    """Return the word label for sensor logical (row, col), or None."""
    if not (0 <= row < GRID and 0 <= col < GRID):
        return None
    with word_boundaries_lock:
        if row not in word_boundaries:
            return None
        for entry in word_boundaries[row]:
            if entry["start"] <= col <= entry["end"]:
                return entry["word"]
    return None


# ── Cell label cache ───────────────────────────────────────────
_cell_word_cache: dict[tuple, str] = {}
_cell_word_cache_lock = threading.Lock()


_cell_labels_dirty = True   # set True whenever word boundaries change

def _rebuild_cell_word_cache() -> None:
    """Recompute heatmap overlay labels from current word_boundaries."""
    global _cell_labels_dirty
    new_cache: dict[tuple, str] = {}
    for r in range(GRID):
        for raw_c in range(GRID):
            w = get_word_from_touch(r, raw_c)
            new_cache[(r, raw_c)] = w if w else ""
    with _cell_word_cache_lock:
        _cell_word_cache.clear()
        _cell_word_cache.update(new_cache)
    _cell_labels_dirty = True


_rebuild_cell_word_cache()


# ══════════════ MANUAL WORD BOUNDARY EDITOR ═══════════════════

class WordBoundaryEditor:
    """Tkinter dialog to inspect and edit word→column-range mappings."""

    def __init__(self, master=None):
        self._root = tk.Tk() if master is None else tk.Toplevel(master)
        self._root.title("Word Boundary Editor")
        self._root.configure(bg="#1a1a2e")
        self._root.resizable(True, True)
        self._build_ui()

    def _build_ui(self):
        root = self._root
        DARK_BG  = "#1a1a2e"
        MID_BG   = "#16213e"
        ENTRY_BG = "#0f3460"
        FG       = "#e0e0e0"
        ACCENT   = "#e94560"
        GRID_FG  = "#a0c4ff"

        style = ttk.Style()
        style.theme_use("clam")
        style.configure("TLabel",    background=DARK_BG, foreground=FG,
                        font=("Courier New", 10))
        style.configure("TFrame",    background=DARK_BG)
        style.configure("TSpinbox",  fieldbackground=ENTRY_BG,
                        background=MID_BG, foreground=FG,
                        arrowcolor=FG, font=("Courier New", 10))
        style.configure("TButton",   background=ACCENT, foreground="white",
                        font=("Courier New", 10, "bold"), relief="flat")
        style.map("TButton",
                  background=[("active", "#c73652"), ("pressed", "#a02840")])

        header = ttk.Label(root,
            text="✎  WORD BOUNDARY EDITOR\n"
                 "Edit word labels. Boundaries are spread evenly per row.",
            font=("Courier New", 11, "bold"), foreground=ACCENT,
            background=DARK_BG, justify="center")
        header.pack(pady=(14, 8), padx=16)

        note = ttk.Label(root,
            text=(f"Grid has {GRID} columns (0–{GRID-1}).  "
                  "Add/remove words by changing the word count spinbox, "
                  "then click Apply."),
            font=("Courier New", 9), foreground=_FG_MUTED,
            background=DARK_BG, wraplength=740, justify="left")
        note.pack(padx=16, pady=(0, 8))

        canvas_frame = tk.Frame(root, bg=DARK_BG)
        canvas_frame.pack(fill="both", expand=True, padx=16, pady=4)

        canvas = tk.Canvas(canvas_frame, bg=DARK_BG, highlightthickness=0)
        scrollbar = ttk.Scrollbar(canvas_frame, orient="vertical",
                                  command=canvas.yview)
        canvas.configure(yscrollcommand=scrollbar.set)
        scrollbar.pack(side="right", fill="y")
        canvas.pack(side="left", fill="both", expand=True)

        inner = tk.Frame(canvas, bg=DARK_BG)
        canvas.create_window((0, 0), window=inner, anchor="nw")

        def _on_configure(evt):
            canvas.configure(scrollregion=canvas.bbox("all"))
        inner.bind("<Configure>", _on_configure)

        self._rows: list[dict] = []

        tk.Label(inner, text="", bg=DARK_BG, fg=FG,
                 font=("Courier New", 9, "bold"),
                 width=6, anchor="center").grid(row=0, column=0, padx=4, pady=2)
        tk.Label(inner, text="# Words", bg=DARK_BG, fg=GRID_FG,
                 font=("Courier New", 9, "bold")).grid(row=0, column=1, padx=4)
        tk.Label(inner,
                 text="Word labels & block widths  →  (widths must sum to 7)",
                 bg=DARK_BG, fg=GRID_FG,
                 font=("Courier New", 9, "bold")).grid(
            row=0, column=2, columnspan=GRID, sticky="w", padx=4)

        with word_boundaries_lock:
            current_boundaries = {k: list(v) for k, v in word_boundaries.items()}

        for row_idx in range(GRID):
            entries = current_boundaries.get(row_idx, [])
            words   = [e["word"] for e in entries]
            widths  = [e["end"] - e["start"] + 1 for e in entries]

            count_var  = tk.IntVar(value=len(words))
            word_vars  = [tk.StringVar(value=w) for w in words]
            width_vars = [tk.IntVar(value=w) for w in widths]

            row_state = {"count_var": count_var, "word_vars": word_vars,
                         "width_vars": width_vars,
                         "frame": None, "row_idx": row_idx}
            self._rows.append(row_state)

            tk.Label(inner, text=f" Row {row_idx}",
                     bg=MID_BG, fg=ACCENT,
                     font=("Courier New", 10, "bold"),
                     width=6, relief="flat").grid(
                row=row_idx + 1, column=0, padx=(4, 2), pady=3, sticky="ew")

            sp = tk.Spinbox(inner, from_=1, to=GRID,
                            textvariable=count_var, width=4,
                            bg=ENTRY_BG, fg=FG,
                            buttonbackground=MID_BG,
                            font=("Courier New", 10),
                            command=lambda idx=row_idx: self._on_count_change(idx))
            sp.grid(row=row_idx + 1, column=1, padx=(2, 8), pady=3)

            wframe = tk.Frame(inner, bg=DARK_BG)
            wframe.grid(row=row_idx + 1, column=2, columnspan=GRID,
                        sticky="w", pady=3)
            row_state["frame"] = wframe
            row_state["entry_bg"] = ENTRY_BG
            row_state["fg"] = FG
            row_state["grid_fg"] = GRID_FG
            self._rebuild_word_entries(row_idx, current_boundaries)

        btn_frame = tk.Frame(root, bg=DARK_BG)
        btn_frame.pack(pady=12)

        tk.Button(btn_frame, text="✔  Apply Changes",
                  bg=ACCENT, fg="white",
                  font=("Courier New", 11, "bold"),
                  relief="flat", padx=16, pady=6,
                  cursor="hand2",
                  command=self._apply).pack(side="left", padx=10)

        tk.Button(btn_frame, text="✖  Close",
                  bg="#333355", fg="#aaaacc",
                  font=("Courier New", 11),
                  relief="flat", padx=16, pady=6,
                  cursor="hand2",
                  command=self._root.destroy).pack(side="left", padx=10)

        root.update_idletasks()
        root.minsize(800, 420)

    def _rebuild_word_entries(self, row_idx: int,
                              boundaries: Optional[dict] = None):
        row_state = self._rows[row_idx]
        wframe    = row_state["frame"]
        ENTRY_BG  = row_state["entry_bg"]
        FG        = row_state["fg"]
        GRID_FG   = row_state["grid_fg"]
        DARK_BG   = "#1a1a2e"

        for child in wframe.winfo_children():
            child.destroy()

        n = row_state["count_var"].get()

        # Rebuild word_vars — preserve existing, pad with empty
        current_words = [v.get() for v in row_state["word_vars"]]
        while len(current_words) < n:
            current_words.append("")
        current_words = current_words[:n]
        row_state["word_vars"] = [tk.StringVar(value=w) for w in current_words]

        # Rebuild width_vars — preserve existing, auto-distribute remainder
        current_widths = [v.get() for v in row_state.get("width_vars", [])]
        while len(current_widths) < n:
            current_widths.append(1)
        current_widths = current_widths[:n]
        # Auto-redistribute if sum doesn't match GRID
        total_w = sum(current_widths)
        if total_w != GRID:
            base, extra = divmod(GRID, n)
            current_widths = [base + (1 if i < extra else 0) for i in range(n)]
        row_state["width_vars"] = [tk.IntVar(value=w) for w in current_widths]

        # Compute column ranges from explicit widths
        ranges = []
        col = 0
        for i in range(n):
            w = current_widths[i]
            ranges.append((col, col + w - 1))
            col += w

        for i, (wvar, wdvar, (s, e)) in enumerate(zip(
                row_state["word_vars"], row_state["width_vars"], ranges)):
            tk.Label(wframe, text=f"[{s}-{e}]",
                     bg=DARK_BG, fg=GRID_FG,
                     font=("Courier New", 8)).grid(
                row=0, column=i * 3, padx=(6, 1), sticky="e")

            tk.Entry(wframe, textvariable=wvar,
                     bg=ENTRY_BG, fg=FG,
                     insertbackground=FG,
                     relief="flat",
                     font=("Courier New", 10),
                     width=max(8, len(wvar.get()) + 2)).grid(
                row=0, column=i * 3 + 1, padx=(1, 1))

            # Width spinbox
            tk.Spinbox(wframe, from_=1, to=GRID,
                       textvariable=wdvar, width=3,
                       bg="#2a2a4e", fg="#ffcc66",
                       buttonbackground=DARK_BG,
                       font=("Courier New", 9)).grid(
                row=0, column=i * 3 + 2, padx=(1, 4))

    def _on_count_change(self, row_idx: int):
        self._rebuild_word_entries(row_idx)

    def _apply(self):
        global word_boundaries

        # Build new text_grid as list of (word, width) tuples
        new_tgrid: list[list[tuple]] = []
        for row_state in self._rows:
            words  = [v.get().strip() for v in row_state["word_vars"]]
            widths = [v.get() for v in row_state.get("width_vars", [])]
            # Fallback: if no width_vars, default all to 1
            while len(widths) < len(words):
                widths.append(1)
            entries = []
            for i, w in enumerate(words):
                label = w if w else f"?{i}"
                entries.append((label, widths[i]))
            # Validate widths sum to GRID
            total_w = sum(widths[:len(words)])
            if total_w != GRID:
                messagebox.showerror(
                    "Invalid widths",
                    f"Row {row_state['row_idx']}: block widths sum to "
                    f"{total_w}, must equal {GRID}.",
                    parent=self._root,
                )
                return
            new_tgrid.append(entries)

        # Preserve extra rows (beyond GRID) from current boundaries
        with word_boundaries_lock:
            all_row_keys = sorted(word_boundaries.keys())
        extra_keys = [k for k in all_row_keys if k >= GRID]
        for k in extra_keys:
            with word_boundaries_lock:
                extra_entries = [(e["word"], e["end"] - e["start"] + 1)
                                 for e in word_boundaries[k]]
            new_tgrid.append(extra_entries)

        new_boundaries = _build_word_boundaries(new_tgrid, GRID)

        with word_boundaries_lock:
            word_boundaries.clear()
            word_boundaries.update(new_boundaries)

        _rebuild_cell_word_cache()

        messagebox.showinfo(
            "Applied",
            "Word boundaries updated!\n"
            "The heatmap overlay and detection logic now use the new mapping.",
            parent=self._root,
        )

    def run(self):
        self._root.mainloop()


# ── Thread-safe signal: background → main thread to open editor ──────────────
# Tkinter windows MUST be created on the main thread.  We use a simple
# threading.Event flag that the main UI loop polls; when set, the loop
# opens the editor on the main thread and clears the flag.
_editor_requested = threading.Event()


def open_word_boundary_editor():
    """Signal the main thread to open the Word Boundary Editor."""
    _editor_requested.set()


def _open_editor_on_main_thread():
    """Actually open the editor — MUST be called from the main thread."""
    _editor_requested.clear()
    editor = WordBoundaryEditor()
    editor.run()  # blocks until the Tk window is closed


# ══════════════════════════════════════════════════════════════
# M-H1: SEEN-SET REGRESSION TRACKER — integrated into WordStatsTracker
# ══════════════════════════════════════════════════════════════
#
# Algorithm summary (from spec M-H1):
#
#   State
#   ─────
#   seen              : set of str   — every unique word touched this session
#   regression_count  : dict[str,int]— how many times each word was re-touched
#   total_regressions : int          — running total of all regression events
#   total_touches     : int          — every touch (new + regression)
#
#   register(word)  — called on every finalised TouchEvent
#   ──────────────
#     total_touches += 1
#     append word to _touch_seq
#     _word_count[word] += 1
#     IF word IN seen:                    ← O(1) hash-set lookup
#         regression_count[word] += 1
#         total_regressions      += 1
#     ELSE:
#         seen.add(word)                  ← O(1) hash-set insert
#
#   snapshot()  — fields added
#   ──────────────────────────
#     hesitation_rate  = total_regressions / total_touches   (0.0 if no touches)
#     top_regressed    = top-5 (word, count) by count desc
#     flagged_words    = words where regression_count > REGRESSION_FLAG_THRESHOLD
#
#   Complexity
#   ──────────
#   Time per touch : O(1)  — single hash lookup + possible insert
#   Memory         : O(V)  — V = unique vocabulary; never grows with total touches

class WordStatsTracker:
    """
    Thread-safe tracker for touch counts, difficulty scores, and
    session-scoped regression detection (M-H1 Seen-Set algorithm).
    """

    def __init__(self):
        self._lock          = threading.Lock()
        self._word_count    = defaultdict(int)
        self._row_count     = defaultdict(int)
        self._word_diff_sum = defaultdict(float)
        self._touch_seq: list[str] = []

        # ── M-H1 regression state ─────────────────────────────
        # _seen maps word -> timestamp of last accepted (non-regression) touch.
        # This replaces the old plain set() to enable time-windowed regression.
        self._seen              : dict[str, float] = {}   # word -> last_seen_time
        self._regression_count  : dict[str, int]   = defaultdict(int)
        self._total_regressions : int              = 0
        self._total_touches     : int              = 0

    def register(self, logical_row: int, logical_col: int,
                 difficulty: float = 0.0) -> Optional[str]:
        """
        Record a touch at (logical_row, logical_col).

        Regression detection (M-H1, time-windowed):
          - In SWEEP_MODE: regression counter is disabled entirely.
          - Otherwise: a touch is a regression only if the same word was
            already touched within REGRESSION_WINDOW_S seconds. After
            that window expires, the cell is treated as a fresh visit.

        Returns the word label (or None if out of bounds).
        """
        word = get_word_from_touch(logical_row, logical_col)
        now  = time.time()
        with self._lock:
            # ── existing tracking ──────────────────────────────
            if word:
                self._word_count[word]       += 1
                self._row_count[logical_row] += 1
                self._word_diff_sum[word]    += difficulty
                self._touch_seq.append(word)

            # ── M-H1: windowed regression check ───────────────
            if word and not SWEEP_MODE:
                self._total_touches += 1
                last_t = self._seen.get(word, None)
                window = REGRESSION_WINDOW_S  # may be None → session-lifetime
                is_regression = (
                    last_t is not None and
                    (window is None or (now - last_t) <= window)
                )
                if is_regression:
                    self._regression_count[word] += 1
                    self._total_regressions      += 1
                else:
                    # Fresh visit (first touch, or window expired) — update stamp
                    self._seen[word] = now

        return word

    def snapshot(self) -> dict:
        """
        Return a point-in-time snapshot of all tracking state,
        including M-H1 regression metrics.
        """
        with self._lock:
            wc  = dict(self._word_count)
            rc  = dict(self._row_count)
            wds = dict(self._word_diff_sum)
            seq = list(self._touch_seq[-20:])

            # ── M-H1 regression snapshot ───────────────────────
            reg_count        = dict(self._regression_count)
            total_regressions = self._total_regressions
            total_touches     = self._total_touches

        most_touched = max(wc, key=wc.get) if wc else None
        avg_diff = {w: wds[w] / wc[w] for w in wc if wc[w] > 0}
        hardest_word = max(avg_diff, key=avg_diff.get) if avg_diff else None

        # ── M-H1 derived fields ────────────────────────────────
        hesitation_rate = (total_regressions / total_touches
                           if total_touches > 0 else 0.0)

        # Top-5 regressed words, sorted by regression count descending
        top_regressed = sorted(
            reg_count.items(), key=lambda x: x[1], reverse=True
        )[:5]

        # Words that have been regressed to more than the flag threshold
        flagged_words = [
            w for w, cnt in reg_count.items()
            if cnt > REGRESSION_FLAG_THRESHOLD
        ]

        return dict(
            word_count=wc,
            row_count=rc,
            most_touched=most_touched,
            hardest_word=hardest_word,
            hardest_word_d=avg_diff.get(hardest_word, 0.0),
            touch_sequence=seq,
            total_registered=sum(wc.values()),
            # ── M-H1 regression fields ─────────────────────────
            hesitation_rate=hesitation_rate,
            total_regressions=total_regressions,
            top_regressed=top_regressed,
            flagged_words=flagged_words,
        )


word_stats = WordStatsTracker()


# ══════════════════════════════════════════════════════════════
# WORD GROUP ACCUMULATOR — multi-block word completion gate
# ══════════════════════════════════════════════════════════════
#
# For multi-block braille words (copper tape spanning 2+ sensor
# columns), this class checks whether all blocks of a word have
# been detected in the touch path before registering the word.
#
# With single-block words (width=1), every touch trivially
# satisfies the check — no behavioral change.
#
# Thread safety: uses word_boundaries_lock (read-only access).

class WordGroupAccumulator:
    """
    Gates word registration until all blocks of a multi-block word
    have been detected in the touch path.

    Usage
    ─────
    accum = WordGroupAccumulator()
    cols_needed = accum.get_required_cols(row, word_label)
    is_complete = accum.check_complete(row, word_label, logical_seq)
    """

    def get_required_cols(self, row: int, word: str) -> set:
        """
        Return the set of columns that must be touched for this word.

        Looks up the word's column range in word_boundaries and returns
        {start, start+1, ..., end}.  Returns empty set if not found.
        """
        with word_boundaries_lock:
            if row not in word_boundaries:
                return set()
            for entry in word_boundaries[row]:
                if entry["word"] == word:
                    return set(range(entry["start"], entry["end"] + 1))
        return set()

    def check_complete(self, row: int, word: str,
                       logical_seq: list) -> bool:
        """
        Check if all required columns for this word appear in logical_seq.

        Parameters
        ----------
        row         : sensor row of the word
        word        : word label
        logical_seq : list of (row, col) tuples from the touch path

        Returns True if every column in the word's range was visited,
        or if the word is a single-block word (trivially complete).
        """
        required = self.get_required_cols(row, word)
        if not required or len(required) <= 1:
            return True  # single-block or not found → always complete

        visited_cols = {col for r, col in logical_seq if r == row}
        return visited_cols >= required


word_group_accum = WordGroupAccumulator()


# ─────────────────────── Geometry helpers ─────────────────────

def map_tx_col(raw_col: int) -> int:
    """Mux wiring correction — used in detection/metrics ONLY."""
    return (raw_col + TX_SHIFT) % GRID


def manhattan(a, b) -> int:
    return abs(a[0] - b[0]) + abs(a[1] - b[1])


def euclid(a, b) -> float:
    return float(np.hypot(a[0] - b[0], a[1] - b[1]))


def path_length(pts) -> float:
    if len(pts) < 2:
        return 0.0
    return float(sum(euclid(pts[i - 1], pts[i]) for i in range(1, len(pts))))


def straight_line(pts) -> float:
    return euclid(pts[0], pts[-1]) if len(pts) >= 2 else 0.0


def count_backtracks(seq) -> int:
    """Count every step that revisits a previously seen cell."""
    if len(seq) < 2:
        return 0
    seen = {seq[0]}
    backtracks = 0
    for cell in seq[1:]:
        if cell in seen:
            backtracks += 1
        else:
            seen.add(cell)
    return backtracks


# ─────────────────────── Serial I/O ───────────────────────────

def read_frame(ser: serial.Serial) -> np.ndarray:
    rows: list = []
    while len(rows) < GRID:
        try:
            line = ser.readline().decode(errors="ignore").strip()
        except serial.SerialException:
            time.sleep(0.01)
            continue
        if not line:
            continue
        parts = line.split()
        # Firmware now appends a CHK{byte} token after the 7 ADC values.
        # Accept rows of length GRID (legacy, no checksum) or GRID+1 (with checksum).
        if len(parts) == GRID + 1 and parts[-1].startswith("CHK"):
            # Validate XOR checksum
            try:
                chk_received = int(parts[-1][3:])
            except ValueError:
                continue  # malformed checksum token — discard
            data_parts = parts[:GRID]
            try:
                vals = list(map(int, data_parts))
            except ValueError:
                continue
            chk_computed = 0
            for v in vals:
                chk_computed ^= (v & 0xFF)
            if chk_computed != chk_received:
                # Checksum mismatch — discard corrupted frame row
                continue
            rows.append(vals)
        elif len(parts) == GRID:
            # Legacy firmware (no checksum) — accept as-is
            try:
                rows.append(list(map(int, parts)))
            except ValueError:
                continue
        else:
            continue
    return np.array(rows, dtype=float)


# ─────────────────────── Touch analysis ───────────────────────

def threshold_mask(delta: np.ndarray) -> np.ndarray:
    return delta >= ROW_THRESHOLDS[:, np.newaxis]


def connected_components_4(mask: np.ndarray):
    visited = np.zeros_like(mask, dtype=bool)
    comps: list = []
    R, C = mask.shape
    for r in range(R):
        for c in range(C):
            if not mask[r, c] or visited[r, c]:
                continue
            stack, comp = [(r, c)], []
            visited[r, c] = True
            while stack:
                rr, cc = stack.pop()
                comp.append((rr, cc))
                for dr, dc in ((-1, 0), (1, 0), (0, -1), (0, 1)):
                    nr, nc = rr + dr, cc + dc
                    if (0 <= nr < R and 0 <= nc < C
                            and mask[nr, nc] and not visited[nr, nc]):
                        visited[nr, nc] = True
                        stack.append((nr, nc))
            comps.append(comp)
    return comps


def analyse_touch(delta: np.ndarray) -> dict:
    EMPTY = dict(active=False, peak_rc=None, pressed_count=0,
                 peak_value=0.0, spread_ratio=0.0, confidence=0.0,
                 peaks=[])
    mask = threshold_mask(delta)
    if mask.sum() < MIN_PRESSED_CELLS:
        return EMPTY
    comps = connected_components_4(mask)
    if not comps:
        return EMPTY

    # Score every component and build a peak info dict for each
    scored: list = []
    for comp in comps:
        vals     = np.array([delta[r, c] for r, c in comp], dtype=float)
        peak_idx = int(np.argmax(vals))
        peak_val = float(vals[peak_idx])
        total    = float(vals.sum())
        spread   = total / (peak_val + 1e-9)
        score    = peak_val * 2.0 + total * 0.5 - (spread - 1.0) * 2.5
        scored.append((score, dict(
            peak_rc=comp[peak_idx],
            pressed_count=len(comp),
            peak_value=peak_val,
            spread_ratio=spread,
            confidence=min(1.0, 1.0 / (spread + 1e-9)),
        )))

    # Sort by score descending
    scored.sort(key=lambda x: x[0], reverse=True)
    
    # Hardware Crosstalk Suppression:
    # Multiplexer/ADC capacitance causes phantom signals on the same row or col,
    # especially during lift-off. If a weaker peak shares a row or col with a 
    # stronger peak AND is < 60% of its value, we classify it as a ghost and drop it.
    filtered_scored = []
    for score, info in scored:
        is_ghost = False
        r, c = info["peak_rc"]
        v = info["peak_value"]
        for _, stronger_info in filtered_scored:
            sr, sc = stronger_info["peak_rc"]
            sv = stronger_info["peak_value"]
            if (r == sr or c == sc) and v < 0.6 * sv:
                is_ghost = True
                break
        if not is_ghost:
            filtered_scored.append((score, info))

    # Keep top 2 valid peaks
    peaks = [info for _score, info in filtered_scored[:2]]

    if not peaks:
        return EMPTY

    # Legacy single-peak fields from the best component (backward compat)
    result = dict(peaks[0])
    result["active"] = True
    result["peaks"]  = peaks
    return result


# ─────────────────────── Peak lock ────────────────────────────

class PeakLock:
    """
    Stabilises the detected peak cell across frames.

    update() now returns a (locked_cell, jumped) tuple:
      - jumped=False  → normal intra-block movement or wobble, no action needed
      - jumped=True   → finger has confirmed moved to a far cell (>= NEW_BLOCK_JUMP_THRESHOLD);
                        caller should finalise the old event and start a new one
    """

    def __init__(self):
        self._hist   = deque(maxlen=PEAK_HISTORY_LEN)
        self._locked = None

    def reset(self, seed=None):
        self._hist.clear()
        self._locked = seed
        if seed is not None:
            self._hist.append(seed)

    def update(self, new_peak):
        """
        Returns (locked_cell, jumped: bool).

        jumped=True means the newly confirmed cell is >= NEW_BLOCK_JUMP_THRESHOLD
        Manhattan units from the previous lock — the caller must treat this as
        a brand-new touch on a different block.
        """
        if new_peak is None:
            return self._locked, False

        self._hist.append(new_peak)
        if len(self._hist) < PEAK_HISTORY_LEN:
            return self._locked, False

        candidate = self._hist[-1]
        consensus = sum(1 for p in self._hist if p == candidate)

        if consensus >= max(1, PEAK_HISTORY_LEN - 1):
            jump = manhattan(candidate, self._locked) if self._locked else 0

            if jump >= NEW_BLOCK_JUMP_THRESHOLD:
                # Large confirmed jump → accept the new cell and signal caller
                self._locked = candidate
                return self._locked, True
            elif jump <= MAX_ACCEPTABLE_JUMP:
                # Small movement within same block → accept silently
                self._locked = candidate

        return self._locked, False

    @property
    def cell(self):
        return self._locked


# ─────────────────────── Difficulty helpers ───────────────────

def compute_velocity_profile(path_pts: list, duration: float) -> np.ndarray:
    if len(path_pts) < 2:
        return np.array([], dtype=float)
    n_steps = len(path_pts) - 1
    dt_per_step = duration / n_steps if n_steps > 0 else 1e-9
    speeds = np.array(
        [euclid(path_pts[i], path_pts[i + 1]) / dt_per_step
         for i in range(n_steps)],
        dtype=float,
    )
    return speeds


def count_zero_crossings(signal: np.ndarray) -> int:
    if len(signal) < 2:
        return 0
    diff = np.diff(signal)
    diff[np.abs(diff) < 1e-9] = 0.0
    signs = np.sign(diff)
    nonzero = signs[signs != 0]
    if len(nonzero) < 2:
        return 0
    return int(np.sum(nonzero[:-1] != nonzero[1:]))


def count_reversals(logical_seq: list) -> int:
    """
    Count direction reversals within a single touch's cell path.
    Requires at least 3 cells (A→B→C where B→C reverses A→B direction).
    Returns 0 for single-cell taps (no path).
    """
    if len(logical_seq) < 3:
        return 0
    col_deltas = [logical_seq[i + 1][1] - logical_seq[i][1]
                  for i in range(len(logical_seq) - 1)]
    reversals = 0
    for i in range(1, len(col_deltas)):
        if col_deltas[i - 1] != 0 and col_deltas[i] != 0:
            if np.sign(col_deltas[i]) != np.sign(col_deltas[i - 1]):
                reversals += 1
    return reversals


def count_word_reversals(word_sequence: list, current_word: str) -> int:
    """
    Detect A→B→A session-level word reversals.

    A word reversal occurs when the current word matches the word touched
    2 events ago, AND differs from the immediately previous event — i.e.
    the user went back to a word they had just left:

        ...→ Word_A → Word_B → Word_A  ← reversal detected here

    Each such reversal adds 1 to the difficulty of the word being returned
    to.  Multiple successive reversals (A→B→A→B→A) each count.

    Args:
        word_sequence: The session touch sequence SO FAR (before appending
                       current_word).  Must have at least 2 entries.
        current_word:  The word being finalised right now.

    Returns: 1 if this event is a word-level reversal, else 0.
    """
    if len(word_sequence) < 2:
        return 0
    prev1 = word_sequence[-1]   # word immediately before this
    prev2 = word_sequence[-2]   # word before that
    # Pattern: prev2 → prev1 → current, where current == prev2 != prev1
    if current_word and current_word == prev2 and current_word != prev1:
        return 1
    return 0


def difficulty_score(reversals: int, zero_crossings: int,
                     velocities: np.ndarray,
                     word_reversals: int = 0) -> float:
    """
    Composite difficulty score in the range [0, ~10].

    Four components:
      REV      : within-touch path direction reversals (finger zigzag)
      ZC       : zero-crossings in velocity (hesitation / jitter)
      VEL      : speed term  — sigmoid(mean_vel); 0 for no movement
      WREV     : session-level word reversals (A→B→A pattern, W4 weight)

    Formula: D = W1*REV + W2*ZC + W3*vel_term + W4*WREV

    Single-cell taps: velocities=[], REV=0, ZC=0 → D = W4*WREV only
    (D=0 if no session reversal, D=W4 if the user reversed back to this word)

    Interpretation:
      0.0 – 1.0  : effortless direct touches
      1.0 – 3.0  : moderate effort, some hesitation or reversals
      3.0+       : high reversal / jitter rate (genuinely hard)
    """
    W4 = 1.5   # weight for session-level word reversal

    if len(velocities) == 0:
        return float(W1 * reversals + W2 * zero_crossings + W4 * word_reversals)

    mean_vel = float(velocities.mean())
    vel_term = mean_vel / (mean_vel + 1.0) if mean_vel > 0 else 0.0
    return float(
        W1 * reversals
        + W2 * zero_crossings
        + W3 * vel_term
        + W4 * word_reversals
    )


# ─────────────────────── Per-cell difficulty tracker ──────────

class CellDifficultyTracker:
    def __init__(self):
        self._lock = threading.Lock()
        self._data: dict = {}  # (row, col) → [sum_D, count]

    def record(self, peak_rc_logical, d_score: float):
        if peak_rc_logical is None:
            return
        cell = tuple(peak_rc_logical)
        with self._lock:
            if cell not in self._data:
                self._data[cell] = [0.0, 0]
            self._data[cell][0] += d_score
            self._data[cell][1] += 1

    def snapshot(self) -> dict:
        with self._lock:
            return {k: v[0] / v[1] for k, v in self._data.items() if v[1] > 0}


# ══════════════════════════════════════════════════════════════
# M-D2: PER-WORD WELFORD BOOKKEEPER
# ══════════════════════════════════════════════════════════════
#
# Tracks per-word n, mean, M2 (for variance) using Welford's online
# algorithm.  Provides session-wide averages and counts that EWIQR
# cannot.  EWIQR is the diagnostician; Welford is the bookkeeper.
#
# Complexity: O(1) per record.  Memory: O(V) where V = unique words.

class WelfordPerWord:
    """Per-word Welford online mean/variance tracker for touch durations."""

    def __init__(self):
        self._lock = threading.Lock()
        self._data: dict[str, list] = {}  # word → [n, mean, M2]

    def record(self, word: str, duration: float) -> None:
        """Update running statistics for *word* with a new *duration*."""
        with self._lock:
            if word not in self._data:
                self._data[word] = [0, 0.0, 0.0]
            rec = self._data[word]
            rec[0] += 1
            delta = duration - rec[1]
            rec[1] += delta / rec[0]
            delta2 = duration - rec[1]
            rec[2] += delta * delta2

    def snapshot(self) -> dict:
        """Return {word: {n, mean, std}} for every tracked word."""
        with self._lock:
            result = {}
            for w, (n, mean, m2) in self._data.items():
                std = (m2 / (n - 1)) ** 0.5 if n > 1 else 0.0
                result[w] = dict(n=n, mean=mean, std=std)
            return result


# ══════════════════════════════════════════════════════════════
# M-D2: EWIQR PER-WORD DIFFICULTY TRACKER
# ══════════════════════════════════════════════════════════════
#
# Algorithm: Exponentially Weighted Interquartile Range (EWIQR)
#
# For each word, maintains a sorted window of (duration, weight) pairs.
# On every new touch:
#   1. All existing weights *= λ  (exponential decay)
#   2. Entries with weight < weight_floor are pruned
#   3. New (duration, 1.0) is inserted maintaining sort order
#
# Weighted percentiles Q1/Q3 are computed by walking cumulative
# weight and recording the duration where cumsum crosses 25%/75%.
# EWIQR = Q3 − Q1 measures *current* inconsistency in the middle
# 50% of touch durations — robust to frequency, outliers, and
# bimodality simultaneously.
#
# Complexity
# ──────────
# record()   : O(m) per word where m = window size (bounded by pruning)
# snapshot() : O(W × m) where W = unique words (sorts are per-word)
# Memory     : O(W × m_avg), independent of session length.

class EWIQRPerWordTracker:
    """
    M-D2: Thread-safe EWIQR per-word difficulty tracker.

    Usage
    ─────
    ewiqr_tracker.record(word, duration)   # called in _finalise_touch()
    snap = ewiqr_tracker.snapshot()        # called in UI loop
    """

    def __init__(self, lam: float = EWIQR_D2_LAMBDA,
                 weight_floor: float = EWIQR_D2_WEIGHT_FLOOR,
                 min_window: int = EWIQR_D2_MIN_WINDOW):
        self._lam          = lam
        self._weight_floor = weight_floor
        self._min_window   = min_window
        self._lock         = threading.Lock()
        # word → sorted list of [duration, weight], sorted ascending by duration
        self._windows: dict[str, list] = defaultdict(list)

    # ── public API ────────────────────────────────────────────

    def record(self, word: str, duration: float) -> None:
        """
        Record a touch duration for *word*.

        Steps (all with lock held):
          1. Decay all existing weights in this word's window by λ
          2. Prune entries below weight_floor
          3. Insert (duration, 1.0) maintaining sort order by duration
        """
        with self._lock:
            window = self._windows[word]

            # Step 1: decay existing weights
            for entry in window:
                entry[1] *= self._lam

            # Step 2: prune below floor
            self._windows[word] = [
                e for e in window if e[1] >= self._weight_floor
            ]
            window = self._windows[word]

            # Step 3: insert new touch maintaining sort order
            # bisect on the duration (index 0 of each [duration, weight] pair)
            durations = [e[0] for e in window]
            pos = bisect.bisect_left(durations, duration)
            window.insert(pos, [duration, 1.0])

    def compute_ewiqr(self, word: str) -> tuple:
        """
        Compute (Q1, Q3, EWIQR, confidence) for a single word.
        Must be called with self._lock held.

        Returns (None, None, None, "cold") if fewer than min_window entries.
        """
        window = self._windows.get(word, [])
        n = len(window)

        if n < self._min_window:
            return (None, None, None, "cold")

        # Compute total weight
        total_weight = sum(e[1] for e in window)
        if total_weight <= 0:
            return (None, None, None, "cold")

        # Find Q1: walk from lowest to highest duration
        q1_threshold = total_weight * 0.25
        q3_threshold = total_weight * 0.75
        accumulated = 0.0
        q1 = None
        q3 = None

        for entry in window:  # already sorted ascending by duration
            accumulated += entry[1]
            if q1 is None and accumulated >= q1_threshold:
                q1 = entry[0]
            if q3 is None and accumulated >= q3_threshold:
                q3 = entry[0]
                break  # both found

        # Fallbacks for edge cases
        if q1 is None:
            q1 = window[0][0]
        if q3 is None:
            q3 = window[-1][0]

        ewiqr = q3 - q1

        # Determine confidence
        if n >= 30:
            confidence = "reliable"
        elif n >= 10:
            confidence = "warming"
        else:
            confidence = "cold"

        return (q1, q3, ewiqr, confidence)

    def snapshot(self) -> dict:
        """
        Full diagnostic snapshot combining EWIQR and Welford data.

        Returns dict with:
          ewiqr_per_word      : {word: ewiqr_value}
          Q1_per_word         : {word: q1_value}
          Q3_per_word         : {word: q3_value}
          confidence_per_word : {word: "cold"/"warming"/"reliable"}
          top5_hardest        : [(word, ewiqr), …]  (max 5, warming+reliable only)
          touch_count_per_word: {word: window_entry_count}
        """
        with self._lock:
            ewiqr_per_word      = {}
            q1_per_word         = {}
            q3_per_word         = {}
            confidence_per_word = {}
            touch_count_per_word = {}

            for word in self._windows:
                q1, q3, ewiqr, conf = self.compute_ewiqr(word)
                touch_count_per_word[word] = len(self._windows[word])
                confidence_per_word[word] = conf
                if ewiqr is not None:
                    ewiqr_per_word[word]  = ewiqr
                    q1_per_word[word]     = q1
                    q3_per_word[word]     = q3

        # Top 5 hardest: rank by EWIQR descending, filter to warming+reliable
        ranked = [
            (w, ewiqr_per_word[w])
            for w in ewiqr_per_word
            if confidence_per_word.get(w) in ("reliable", "warming")
        ]
        ranked.sort(key=lambda x: x[1], reverse=True)
        top5 = ranked[:5]

        # Build Z_tot: 7×7 masked array of EWIQR mapped to grid positions
        z_tot = np.ma.masked_all((GRID, GRID))
        with word_boundaries_lock:
            for row_idx in range(GRID):
                if row_idx not in word_boundaries:
                    continue
                for entry in word_boundaries[row_idx]:
                    w = entry["word"]
                    if w in ewiqr_per_word:
                        # Fill all columns this word spans
                        for c in range(entry["start"], entry["end"] + 1):
                            if 0 <= c < GRID:
                                z_tot[row_idx, c] = ewiqr_per_word[w]

        return dict(
            ewiqr_per_word=ewiqr_per_word,
            Q1_per_word=q1_per_word,
            Q3_per_word=q3_per_word,
            confidence_per_word=confidence_per_word,
            touch_count_per_word=touch_count_per_word,
            top5_hardest=top5,
            Z_tot=z_tot,
        )


# ══════════════════════════════════════════════════════════════
# M-D3: SKIP STATISTICS ENGINE
# ══════════════════════════════════════════════════════════════
#
# Two-layer architecture with a numpy boolean mask as interface.
#
# Layer 1 — Single-Pass Accumulator
# ──────────────────────────────────
# One sweep across word_boundaries produces four outputs atomically:
#   skip_rate, skipped_words, partially_visited_rows, skip_mask
# Stale keys in word_count are structurally unreachable because
# labels are sourced exclusively from word_boundaries.
#
# Layer 2 — BFS Cluster Analysis
# ──────────────────────────────
# Takes skip_mask as sole input.  Finds connected components of
# True cells via 4-connected BFS.  Classifies each cluster's
# spatial morphology (row-sweep, column-alignment, boundary
# avoidance, saccade drift, singleton noise, scattered gap).
# Clusters with < 4 cells are suppressed as noise.

SKIP_CLUSTER_MIN_SIZE = 4   # clusters smaller than this are noise


def compute_skip_stats(wb: dict, wc: dict) -> dict:
    """
    M-D3 Layer 1 — Single-Pass Accumulator.

    Parameters
    ----------
    wb : dict  — word_boundaries  {row_idx: [{word, start, end}, …]}
    wc : dict  — word_count       {word_label: touch_count}

    Returns
    -------
    dict with keys:
        skip_rate              : float   (percentage 0–100)
        skipped_words          : list[str]  (row-major order)
        partially_visited_rows : list[int]
        skip_mask              : np.ndarray  (7×7 bool)
    """
    # Count total WORDS (not raw cells) — depends on user config
    TOTAL_WORDS = sum(len(wb.get(r, [])) for r in range(GRID))

    skip_count        = 0
    skipped_words     = []
    partially_visited = []
    skip_mask         = np.zeros((GRID, GRID), dtype=bool)

    for row_idx in range(GRID):
        words_in_row      = wb.get(row_idx, [])
        row_total         = len(words_in_row)
        row_touched_count = 0

        for entry in words_in_row:
            label       = entry["word"]
            touch_count = wc.get(label, 0)
            was_touched = (touch_count > 0)

            if not was_touched:
                skipped_words.append(label)
                skip_count += 1
                # Mark ALL columns spanned by this word in skip_mask
                for c in range(entry["start"], entry["end"] + 1):
                    if 0 <= c < GRID:
                        skip_mask[row_idx][c] = True
            else:
                row_touched_count += 1

        # Row is partially visited only if SOME but NOT ALL words touched
        if row_touched_count > 0 and row_touched_count < row_total:
            partially_visited.append(row_idx)

    skip_rate = (skip_count / TOTAL_WORDS) * 100.0 if TOTAL_WORDS > 0 else 0.0

    return dict(
        skip_rate=skip_rate,
        skipped_words=skipped_words,
        partially_visited_rows=partially_visited,
        skip_mask=skip_mask,
        total_words=TOTAL_WORDS,
    )


def _classify_cluster(cells: list) -> dict:
    """
    Classify a single skip cluster by its bounding-box geometry.

    Returns dict with: cells, size, bounding_box, pattern, is_noise.
    """
    size    = len(cells)
    rows    = [r for r, c in cells]
    cols    = [c for r, c in cells]
    min_row, max_row = min(rows), max(rows)
    min_col, max_col = min(cols), max(cols)
    row_span = max_row - min_row + 1
    col_span = max_col - min_col + 1

    if size < SKIP_CLUSTER_MIN_SIZE:
        pattern  = "singleton_noise"
        is_noise = True

    elif row_span == 1 and col_span == GRID:
        pattern  = "row_sweep_failure"
        is_noise = False

    elif row_span == GRID and col_span == 1:
        pattern  = "column_alignment_failure"
        is_noise = False

    elif (min_row <= 1 or max_row >= 5) and (min_col <= 1 or max_col >= 5):
        pattern  = "boundary_avoidance"
        is_noise = False

    elif abs(row_span - col_span) <= 1:
        pattern  = "saccade_drift"
        is_noise = False

    else:
        pattern  = "scattered_attentional_gap"
        is_noise = False

    return dict(
        cells=cells,
        size=size,
        bounding_box=(min_row, min_col, max_row, max_col),
        pattern=pattern,
        is_noise=is_noise,
    )


def compute_skip_clusters(skip_mask: np.ndarray) -> list:
    """
    M-D3 Layer 2 — BFS Cluster Analysis.

    Parameters
    ----------
    skip_mask : np.ndarray  — 7×7 boolean array from compute_skip_stats

    Returns
    -------
    list of cluster dicts, each with:
        cells, size, bounding_box, pattern, is_noise
    """
    DIRECTIONS = [(-1, 0), (1, 0), (0, -1), (0, 1)]

    visited  = np.zeros((GRID, GRID), dtype=bool)
    clusters = []

    for row in range(GRID):
        for col in range(GRID):
            if skip_mask[row, col] and not visited[row, col]:
                # Seed of a new cluster — BFS
                current_cells = []
                q = deque()
                q.append((row, col))
                visited[row, col] = True

                while q:
                    r, c = q.popleft()
                    current_cells.append((r, c))

                    for dr, dc in DIRECTIONS:
                        nr, nc = r + dr, c + dc
                        if 0 <= nr < GRID and 0 <= nc < GRID:
                            if skip_mask[nr, nc] and not visited[nr, nc]:
                                visited[nr, nc] = True
                                q.append((nr, nc))

                clusters.append(_classify_cluster(current_cells))

    return clusters


# ══════════════════════════════════════════════════════════════
# LIVE DUAL-AXIS BAR CHART — Persistent Artist Blit
# ══════════════════════════════════════════════════════════════
#
# Algorithm: PersistentArtistBlit
#
# Allocates every matplotlib artist exactly once during setup.
# On every subsequent update, only the numerical properties of
# those existing objects are mutated — never destroyed, never
# recreated.  Then only the pixels that actually changed are
# repainted via the blit pipeline.
#
# Phase 1 (Setup):  Runs exactly once.  Creates 49 primary bars
#   (Time-on-Task, left axis), 49 count bars (touch count, right
#   axis), error bar stems + caps, 49 asterisk text artists for
#   difficulty annotation, and one horizontal dashed session-avg
#   line.  A full draw is performed and a background pixel-buffer
#   snapshot is captured.
#
# Phase 2 (Update):  Called every UI frame but short-circuits if
#   < 500ms since last update (~2fps).  Mutates bar heights, error
#   bar geometry, axis limits (with hysteresis), asterisk visibility,
#   and h-line y-data.  Then restores the background snapshot, draws
#   all mutated artists on top, and blits only the changed bbox.
#
# Complexity
# ──────────
# Per UI frame (no-op) : O(1) — one timestamp comparison
# Per chart update     : O(W) — W=49 words, property writes
# Memory               : O(W) — fixed artist pool, no GC churn
# ══════════════════════════════════════════════════════════════

BAR_CHART_UPDATE_INTERVAL = 0.5   # seconds — chart updates at ~2fps


class BarChartBlit:
    """
    Persistent Artist Blit dual-axis bar chart.

    Shows per-word Time-on-Task (left Y-axis) and touch counts
    (right Y-axis) with error bars, difficulty asterisks for the
    top-5 hardest words, and a session average h-line.

    All artists are allocated once in setup().  update() mutates
    only numerical properties and blits only changed pixels.
    """

    def __init__(self):
        # ── Data structures from pseudocode ────────────────────
        self.word_list       = []        # ordered array[49] of word labels
        self.primary_bars    = []        # Rectangle artists (left axis, ToT)
        self.count_bars      = []        # Rectangle artists (right axis, count)
        self.error_stems     = None      # LineCollection (49 segments)
        self.error_caps_lo   = None      # Line2D (bottom caps)
        self.error_caps_hi   = None      # Line2D (top caps)
        self.asterisk_texts  = []        # Text artists (all initially invisible)
        self.hline           = None      # Line2D artist (session avg)
        self.background_snap = None      # pixel buffer
        self.last_chart_time = -1e9      # initially −∞
        self.prev_top5       = set()     # set of word indices
        self.left_limit_max  = 0.0
        self.right_limit_max = 0.0
        self.fig             = None
        self.ax_left         = None
        self.ax_right        = None
        self._setup_done     = False

    def setup(self, word_boundaries_dict: dict) -> None:
        """
        Phase 1: Create all artists exactly once.

        Extracts word list in row-major order from word_boundaries,
        creates dual-axis bar chart with error bars, asterisks, and
        h-line, then captures background pixel buffer.
        """
        # ── Extract word list in row-major order ──────────────
        self.word_list = []
        for row_idx in range(GRID):
            entries = word_boundaries_dict.get(row_idx, [])
            for entry in entries:
                self.word_list.append(entry["word"])
        # Word count is dynamic — depends on user block-width config

        n_words = len(self.word_list)
        x_pos   = np.arange(n_words)

        # ── Create figure and axes ────────────────────────────
        self.fig = plt.figure(figsize=(14, 5), facecolor=_BG_DARK)
        self.ax_left  = self.fig.add_subplot(111)
        self.ax_right = self.ax_left.twinx()

        self.ax_left.set_facecolor(_BG_DARK)
        self.fig.patch.set_facecolor(_BG_DARK)

        # ── tab10 palette by row ──────────────────────────────
        tab10 = plt.cm.tab10

        # ── Build per-word row mapping for color assignment ─────
        self._word_row = []   # word_row[i] = sensor row of word i
        for row_idx in range(GRID):
            entries = word_boundaries_dict.get(row_idx, [])
            for _ in entries:
                self._word_row.append(row_idx)

        # ── Create primary bars (ToT, left axis) ──────────────
        self.primary_bars = []
        self.count_bars   = []
        bar_width = 0.35

        for i in range(n_words):
            row = self._word_row[i] if i < len(self._word_row) else 0
            color = tab10(row)

            bar_p = self.ax_left.bar(
                i - bar_width / 2, 0, bar_width,
                color=color, alpha=1.0, edgecolor='none'
            )[0]
            self.primary_bars.append(bar_p)

            bar_c = self.ax_right.bar(
                i + bar_width / 2, 0, bar_width,
                color=color, alpha=0.3, edgecolor='none'
            )[0]
            self.count_bars.append(bar_c)

        # ── Create error bars ─────────────────────────────────
        # Use errorbar() with zero values to create the artists
        err_container = self.ax_left.errorbar(
            x_pos, np.zeros(n_words), yerr=np.zeros(n_words),
            fmt='none', ecolor='#ffffff', elinewidth=0.8,
            capsize=2, capthick=0.6, alpha=0.5
        )
        # err_container is an ErrorbarContainer:
        #   [0] = data line (Line2D, 'none' format → may be empty)
        #   [1] = cap lines tuple of Line2D
        #   [2] = bar lines tuple of LineCollection
        self.error_caps_lo = err_container[1][0] if len(err_container[1]) > 0 else None
        self.error_caps_hi = err_container[1][1] if len(err_container[1]) > 1 else None
        self.error_stems   = err_container[2][0] if len(err_container[2]) > 0 else None

        # ── Create asterisk Text artists ──────────────────────
        self.asterisk_texts = []
        for i in range(n_words):
            txt = self.ax_left.text(
                i, 0, "*",
                ha='center', va='bottom',
                fontsize=14, fontweight='bold',
                color='#ff4444', visible=False
            )
            self.asterisk_texts.append(txt)

        # ── Create h-line (session average) ───────────────────
        self.hline = self.ax_left.axhline(
            y=0, color='#00ffaa', linestyle='--',
            linewidth=1.2, alpha=0.7
        )

        # ── Axis labels and ticks ─────────────────────────────
        self.ax_left.set_xticks(x_pos)
        self.ax_left.set_xticklabels(
            self.word_list, rotation=45, ha='right',
            fontsize=7, color=_FG_MUTED
        )
        self.ax_left.set_ylabel('Time-on-Task (s)', color=_FG_PRIMARY, fontsize=9)
        self.ax_right.set_ylabel('Touch Count', color=_FG_PRIMARY, fontsize=9)
        self.ax_left.tick_params(axis='y', colors=_FG_MUTED)
        self.ax_right.tick_params(axis='y', colors=_FG_MUTED)
        self.ax_left.set_title(
            'Per-Word Performance  (Time-on-Task & Touch Counts)',
            color='white', fontsize=11, fontweight='bold', pad=10
        )
        self.ax_left.set_xlim(-0.5, n_words - 0.5)
        self.ax_left.set_ylim(0, 1.0)
        self.ax_right.set_ylim(0, 1.0)

        # Grid
        self.ax_left.grid(axis='y', color=_GRID_COLOR, linewidth=0.5, alpha=0.5)

        # Spines
        for sp in self.ax_left.spines.values():
            sp.set_edgecolor(_GRID_COLOR)
        for sp in self.ax_right.spines.values():
            sp.set_edgecolor(_GRID_COLOR)

        self.fig.tight_layout()

        # ── Full draw + capture background snapshot ───────────
        self.fig.canvas.draw()
        self.background_snap = self.fig.canvas.copy_from_bbox(
            self.ax_left.bbox
        )

        # ── Register resize handler ───────────────────────────
        self.fig.canvas.mpl_connect('resize_event', self._on_resize)

        self._setup_done = True

    def _on_resize(self, event=None):
        """Resize invalidates the pixel buffer — must recapture."""
        if self._setup_done:
            self.fig.canvas.draw()
            self.background_snap = self.fig.canvas.copy_from_bbox(
                self.ax_left.bbox
            )

    def update(self, tot_per_word: dict, std_per_word: dict,
               word_count: dict, mean_D_per_word: dict,
               session_avg_duration: float) -> None:
        """
        Phase 2: Throttled update (~2fps).

        Mutates existing artist properties and blits only the changed
        bounding box.  Returns immediately if < 500ms since last update.
        """
        if not self._setup_done:
            return

        # ── Step A: Throttle gate ─────────────────────────────
        now = time.time()
        if (now - self.last_chart_time) < BAR_CHART_UPDATE_INTERVAL:
            return
        self.last_chart_time = now

        n_words = len(self.word_list)

        # ── Step B: Mutate primary and count bar heights ──────
        for i in range(n_words):
            word = self.word_list[i]
            self.primary_bars[i].set_height(
                tot_per_word.get(word, 0.0)
            )
            self.count_bars[i].set_height(
                word_count.get(word, 0)
            )

        # ── Step C: Mutate error bar geometry ─────────────────
        if self.error_stems is not None:
            new_segments = []
            cap_lo_y = []
            cap_hi_y = []
            for i in range(n_words):
                word  = self.word_list[i]
                mid   = tot_per_word.get(word, 0.0)
                sigma = std_per_word.get(word, 0.0)
                lo = max(0, mid - sigma)
                hi = mid + sigma
                new_segments.append([(i, lo), (i, hi)])
                cap_lo_y.append(lo)
                cap_hi_y.append(hi)

            self.error_stems.set_segments(new_segments)

            if self.error_caps_lo is not None:
                self.error_caps_lo.set_ydata(cap_lo_y)
            if self.error_caps_hi is not None:
                self.error_caps_hi.set_ydata(cap_hi_y)

        # ── Step D: Axis limit guard (hysteresis) ─────────────
        all_tot = [tot_per_word.get(w, 0.0) for w in self.word_list]
        all_cnt = [word_count.get(w, 0) for w in self.word_list]
        new_left_max  = max(all_tot)  if all_tot else 0.0
        new_right_max = max(all_cnt)  if all_cnt else 0.0

        needs_full_redraw = False

        if (self.left_limit_max == 0 and new_left_max > 0) or \
           (self.left_limit_max > 0 and
            (new_left_max > self.left_limit_max * 1.1 or
             new_left_max < self.left_limit_max * 0.6)):
            self.ax_left.set_ylim(0, max(0.1, new_left_max * 1.15))
            self.left_limit_max = new_left_max
            needs_full_redraw = True

        if (self.right_limit_max == 0 and new_right_max > 0) or \
           (self.right_limit_max > 0 and
            (new_right_max > self.right_limit_max * 1.1 or
             new_right_max < self.right_limit_max * 0.6)):
            self.ax_right.set_ylim(0, max(1.0, new_right_max * 1.15))
            self.right_limit_max = new_right_max
            needs_full_redraw = True

        if needs_full_redraw:
            self.fig.canvas.draw()
            self.background_snap = self.fig.canvas.copy_from_bbox(
                self.ax_left.bbox
            )

        # ── Step E: Asterisk visibility delta ─────────────────
        # Find top 5 words by mean difficulty score
        valid_diff = [
            (i, mean_D_per_word.get(self.word_list[i], 0.0))
            for i in range(n_words)
            if mean_D_per_word.get(self.word_list[i], 0.0) > 0
        ]
        valid_diff.sort(key=lambda x: x[1], reverse=True)
        current_top5 = set(idx for idx, _ in valid_diff[:5])

        entered = current_top5 - self.prev_top5
        exited  = self.prev_top5 - current_top5

        for i in entered:
            word = self.word_list[i]
            y_pos = (tot_per_word.get(word, 0.0)
                     + std_per_word.get(word, 0.0) + 0.05)
            self.asterisk_texts[i].set_y(y_pos)
            self.asterisk_texts[i].set_visible(True)

        for i in exited:
            self.asterisk_texts[i].set_visible(False)

        # Update positions for existing top5 (bar heights may have changed)
        for i in (current_top5 & self.prev_top5):
            word = self.word_list[i]
            y_pos = (tot_per_word.get(word, 0.0)
                     + std_per_word.get(word, 0.0) + 0.05)
            self.asterisk_texts[i].set_y(y_pos)

        self.prev_top5 = current_top5

        # ── Step F: H-line update ─────────────────────────────
        self.hline.set_ydata([session_avg_duration, session_avg_duration])

        # ── Step G: Blit repaint ──────────────────────────────
        if self.background_snap is not None:
            self.fig.canvas.restore_region(self.background_snap)

            # Draw all mutated artists onto restored background
            for bar in self.primary_bars:
                self.ax_left.draw_artist(bar)
            for bar in self.count_bars:
                self.ax_right.draw_artist(bar)

            if self.error_stems is not None:
                self.ax_left.draw_artist(self.error_stems)
            if self.error_caps_lo is not None:
                self.ax_left.draw_artist(self.error_caps_lo)
            if self.error_caps_hi is not None:
                self.ax_left.draw_artist(self.error_caps_hi)

            for txt in self.asterisk_texts:
                if txt.get_visible():
                    self.ax_left.draw_artist(txt)

            self.ax_left.draw_artist(self.hline)

            self.fig.canvas.blit(self.ax_left.bbox)


# ══════════════════════════════════════════════════════════════
# V-4: MEDIAN PRE-FILTER → EMA  —  LIVE WPM TREND
# ══════════════════════════════════════════════════════════════
#
# Two-stage pipeline for producing a smooth WPM trend line:
#
#   Stage 1 — Median Pre-filter (window=3)
#   ───────────────────────────────────────
#   Raw WPM is pathologically noisy: a mixture of genuine typing
#   speed and impulsive event noise (pauses, stumbles, backspaces).
#   The median of the last 3 samples has a 50% breakdown point —
#   it ignores the single most extreme value entirely.  This kills
#   isolated spikes while passing through sustained speed changes.
#
#   Stage 2 — EMA (α=0.15)
#   ───────────────────────
#   Because the pre-filter already removed impulsive noise, the
#   EMA only needs to smooth residual variance.  α=0.15 gives
#   a half-life of ~0.9s at 5fps — fast enough for timely feedback
#   during flow states, slow enough to ignore sub-second stumbles.
#
# Complexity
# ──────────
# on_frame()  : O(1) — sort 3 numbers + one multiply-add
# get_plot_data() : O(N) — one pass over raw_buffer to recompute
#                   the EMA series for the full plot line
# Memory      : O(N) where N ≤ 720 (2 minutes at 6fps)

class WPMTrendTracker:
    """
    V-4: Median Pre-filter → EMA for live WPM trend.

    Produces a smooth, responsive trend line from noisy raw WPM
    samples by separating impulsive noise (median) from sustained
    variance (EMA).

    Usage
    ─────
    wpm_trend.on_frame(current_wpm, timestamp)
    x_raw, y_raw, y_ema, y_max = wpm_trend.get_plot_data()
    """

    def __init__(self, alpha: float = WPM_TREND_ALPHA,
                 median_window: int = WPM_TREND_MEDIAN_WINDOW,
                 buffer_maxlen: int = WPM_TREND_BUFFER_MAXLEN,
                 update_interval: float = WPM_TREND_UPDATE_INTERVAL):
        self._alpha           = alpha
        self._median_window   = median_window
        self._update_interval = update_interval

        self._raw_buffer: deque   = deque(maxlen=buffer_maxlen)   # (timestamp, wpm)
        self._med_window: deque   = deque(maxlen=median_window)   # last N raw WPM values
        self._ema_state: float    = None                          # None until first sample
        self._last_update: float  = 0.0
        self._lock                = threading.Lock()

    # ── public API ────────────────────────────────────────────

    def on_frame(self, current_wpm: float, timestamp: float) -> float:
        """
        Process one raw WPM sample through the two-stage pipeline.

        Throttled to ~5fps (UPDATE_INTERVAL = 0.2s).  Returns the
        current EMA state, or None if throttled / cold-start.
        """
        with self._lock:
            # Throttle to 5fps inside the 60fps render loop
            if (timestamp - self._last_update) < self._update_interval:
                return self._ema_state

            self._last_update = timestamp

            # --- Stage 0: Buffer the raw sample ---
            self._raw_buffer.append((timestamp, current_wpm))

            # --- Stage 1: Median Pre-filter ---
            self._med_window.append(current_wpm)
            sorted_window = sorted(self._med_window)
            pre_filtered  = sorted_window[len(sorted_window) // 2]  # true median

            # --- Stage 2: EMA on pre-filtered value ---
            if self._ema_state is None:
                self._ema_state = pre_filtered              # cold-start: no lag
            else:
                self._ema_state = (self._alpha * pre_filtered
                                   + (1.0 - self._alpha) * self._ema_state)

            return self._ema_state

    def get_plot_data(self) -> tuple:
        """
        Return (x_raw, y_raw, y_ema, y_max) for plotting.

        x_raw : relative timestamps (seconds from session start)
        y_raw : raw WPM samples
        y_ema : EMA series recomputed over the full raw buffer
        y_max : auto-scale ceiling for Y-axis

        Returns ([], [], [], 0) if no data yet.
        """
        with self._lock:
            if not self._raw_buffer:
                return [], [], [], 0

            buf = list(self._raw_buffer)

        session_start = buf[0][0]
        x_raw = [t - session_start for t, _ in buf]
        y_raw = [wpm for _, wpm in buf]

        # Recompute EMA series from pre-filtered values over full history
        y_ema = self._recompute_ema_series(y_raw)

        y_max = max(y_raw) + 10 if y_raw else 10

        return x_raw, y_raw, y_ema, y_max

    def get_current_ema(self) -> float:
        """Return the current EMA value (thread-safe)."""
        with self._lock:
            return self._ema_state if self._ema_state is not None else 0.0

    def reset(self) -> None:
        with self._lock:
            self._raw_buffer.clear()
            self._med_window.clear()
            self._ema_state   = None
            self._last_update = 0.0

    # ── internal ─────────────────────────────────────────────

    def _recompute_ema_series(self, values: list) -> list:
        """
        Recompute the full EMA series over raw values for plot display.

        NOTE: For strict correctness the series should be computed over
        pre-filtered (median) values.  We apply the median pre-filter
        here as well so the plot line matches the live EMA state.
        """
        if not values:
            return []

        result = []
        med_win = deque(maxlen=self._median_window)
        state = None

        for v in values:
            med_win.append(v)
            sorted_w = sorted(med_win)
            pre_filtered = sorted_w[len(sorted_w) // 2]

            if state is None:
                state = pre_filtered
            else:
                state = self._alpha * pre_filtered + (1.0 - self._alpha) * state
            result.append(state)

        return result


# ══════════════════════════════════════════════════════════════
# V-5: INTER-WORD REGRESSION BAR CHART — cla() Full Redraw
# ══════════════════════════════════════════════════════════════
#
# Algorithm: cla()-based stateless redraw at ~2fps
#
# Two layers running at different frequencies share a snapshot:
#
# Layer 1 — Data Capture (60fps, inside UI loop)
# ──────────────────────────────────────────────
# Copies regression_count + flagged_words into snapshot.
# Checks elapsed time; if ≥ 500ms, hands snapshot to Layer 2.
#
# Layer 2 — Chart Redraw (~2fps)
# ──────────────────────────────
# 7-step stateless reconstruction:
#   1. Filter:  discard words with zero regressions
#   2. Sort:    descending by regression count
#   3. Colour:  red if flagged, blue otherwise
#   4. Clear:   ax.cla() — destroys all artists, preserves GridSpec
#   5. Empty:   guard against empty filtered list
#   6. Draw:    barh() + annotations (inside/outside placement)
#   7. Render:  title, xlabel, draw_idle()
#
# Complexity
# ──────────
# Per UI frame (no-op) : O(1) — timestamp comparison
# Per chart update     : O(W log W) — sort ≤20 words + barh()
# Memory               : O(W) — one dict snapshot per update
# ══════════════════════════════════════════════════════════════


class RegressionBarChart:
    """
    V-5: Inter-Word Regression Bar Chart.

    Horizontal bar chart showing which words the reader regresses to
    most.  Uses cla() full-redraw at ~2fps for simplicity and
    correctness — every update is stateless.

    Usage
    ─────
    reg_chart.setup()                       # once, creates figure
    reg_chart.update(regression_count,      # called every UI frame
                     flagged_words)         # (throttled internally)
    """

    # ── Colour palette ────────────────────────────────────────
    COLOR_FLAGGED = "#ff4444"     # red — word exceeded threshold
    COLOR_NORMAL  = "#4488ff"     # blue — below threshold
    COLOR_BG      = _BG_DARK     # figure/axes background
    COLOR_TEXT    = _FG_PRIMARY     # annotation text
    COLOR_EMPTY   = "#666666"     # placeholder text when no data

    def __init__(self):
        self.fig             = None
        self.ax              = None
        self._last_draw_time = 0.0
        self._setup_done     = False

    def setup(self) -> None:
        """
        Create the figure and axes.  Called once before the UI loop.
        The axes content is intentionally left empty — the first
        update() call will populate it.
        """
        self.fig = plt.figure(figsize=(8, 5), facecolor=self.COLOR_BG)
        self.ax  = self.fig.add_subplot(111)
        self.ax.set_facecolor(self.COLOR_BG)
        self.fig.patch.set_facecolor(self.COLOR_BG)

        # Initial placeholder
        self.ax.set_title(
            "Most-Regressed Words  (inter-word regressions)",
            color="white", fontsize=11, fontweight="bold", pad=10
        )
        self.ax.set_xlabel("Regression count", color=_FG_MUTED, fontsize=9)
        self.ax.text(
            0.5, 0.5, "No regressions recorded yet",
            transform=self.ax.transAxes,
            ha="center", va="center",
            fontsize=12, color=self.COLOR_EMPTY,
            fontstyle="italic"
        )
        self.ax.tick_params(colors="#777777")
        for sp in self.ax.spines.values():
            sp.set_edgecolor(_GRID_COLOR)

        self.fig.tight_layout()
        self._setup_done = True

    def update(self, regression_count: dict, flagged_words: list) -> None:
        """
        Layer 1 + Layer 2 combined.

        Called every UI frame (~60fps).  Checks the throttle gate;
        if ≥ REGRESSION_CHART_UPDATE_INTERVAL has elapsed, performs
        the full 7-step cla() redraw.

        Parameters
        ----------
        regression_count : dict[str, int]
            Word → regression count, from WordStatsTracker.
        flagged_words : list[str]
            Words exceeding REGRESSION_FLAG_THRESHOLD.
        """
        if not self._setup_done:
            return

        # ── Layer 1: Throttle gate ────────────────────────────
        now = time.time()
        if (now - self._last_draw_time) < REGRESSION_CHART_UPDATE_INTERVAL:
            return
        self._last_draw_time = now

        # ── Layer 2: Full chart redraw ────────────────────────
        self._redraw(regression_count, flagged_words)

    def _redraw(self, regression_count: dict, flagged_words: list) -> None:
        """
        7-step stateless chart reconstruction.

        Every call produces a complete, consistent chart from the
        current data.  No state from previous draws is referenced.
        """
        ax = self.ax

        # ── Step 1: Filter — keep only words with count > 0 ──
        visible = {
            word: count
            for word, count in regression_count.items()
            if count > 0
        }

        # ── Step 2: Sort — descending by count ────────────────
        sorted_items  = sorted(visible.items(),
                               key=lambda x: x[1], reverse=True)
        sorted_words  = [item[0] for item in sorted_items]
        sorted_counts = [item[1] for item in sorted_items]

        # ── Step 3: Colour assignment ─────────────────────────
        flagged_set = set(flagged_words)
        colours = [
            self.COLOR_FLAGGED if word in flagged_set
            else self.COLOR_NORMAL
            for word in sorted_words
        ]

        # ── Step 4: Clear axes ────────────────────────────────
        ax.cla()

        # ── Step 5: Empty state guard ─────────────────────────
        if not sorted_words:
            ax.text(
                0.5, 0.5, "No regressions recorded yet",
                transform=ax.transAxes,
                ha="center", va="center",
                fontsize=12, color=self.COLOR_EMPTY,
                fontstyle="italic"
            )
            # Skip to Step 7
            self._apply_labels(ax)
            return

        # ── Step 6: Draw bars + annotations ───────────────────
        bars = ax.barh(
            range(len(sorted_words)), sorted_counts,
            color=colours, edgecolor="none", height=0.65,
            alpha=0.9
        )
        ax.set_yticks(range(len(sorted_words)))
        ax.set_yticklabels(sorted_words, fontsize=9, color=self.COLOR_TEXT)
        ax.invert_yaxis()  # highest count at top

        # Annotations: count label placed inside or outside bar
        max_count = max(sorted_counts) if sorted_counts else 1
        threshold = max_count * 0.3  # bars shorter than 30% of max → label outside

        for i, count in enumerate(sorted_counts):
            if count > threshold and count >= 2:
                # Inside the bar, right-aligned
                x_pos = count - max_count * 0.02
                ax.text(
                    x_pos, i, str(count),
                    ha="right", va="center",
                    fontsize=9, fontweight="bold",
                    color="white"
                )
            else:
                # Outside the bar, left-aligned
                x_pos = count + max_count * 0.02
                ax.text(
                    x_pos, i, str(count),
                    ha="left", va="center",
                    fontsize=9, fontweight="bold",
                    color=self.COLOR_TEXT
                )

        # X-axis styling
        ax.set_xlim(0, max(1, max_count * 1.15))
        ax.grid(axis="x", color=_GRID_COLOR, linewidth=0.5, alpha=0.5)

        # ── Step 7: Labels + render ───────────────────────────
        self._apply_labels(ax)

    def _apply_labels(self, ax) -> None:
        """Set title, xlabel, spine colours, and post draw_idle()."""
        ax.set_title(
            "Most-Regressed Words  (inter-word regressions)",
            color="white", fontsize=11, fontweight="bold", pad=10
        )
        ax.set_xlabel("Regression count", color=_FG_MUTED, fontsize=9)
        ax.tick_params(colors="#777777")
        for sp in ax.spines.values():
            sp.set_edgecolor(_GRID_COLOR)
        ax.set_facecolor(self.COLOR_BG)

        self.fig.canvas.draw_idle()


# ══════════════════════════════════════════════════════════════
# V-6: 3D SURFACE MONITOR — Interactive Surface Replacement
# ══════════════════════════════════════════════════════════════
#
# Algorithm: Surface Replacement
#
# The 3D view plots per-cell metrics as a surface over the 7×7
# sensor grid.  Two Z-surfaces are selectable via RadioButtons:
#   - Time-on-Task (Z_tot): mean touch duration from Welford
#   - Mean Difficulty (Z_diff): EWIQR difficulty score per word
#
# Toggling replaces ONLY the PolyCollection surface artist.
# The Axes3D object, wireframe, base labels, and camera view
# angle are preserved across toggles — no flicker, no reset.
#
# Throttled at 2fps to match other chart update cadences.
#
# Complexity
# ──────────
# init    : O(W)   — one surface plot + W text labels
# toggle  : O(1)   — remove one artist + plot one surface
# Memory  : O(W)   — two 7×7 arrays, W text artists
# ══════════════════════════════════════════════════════════════


class Monitor3D:
    """
    V-6: Interactive 3D Surface Monitor with RadioButtons toggle.

    Visualises per-cell Time-on-Task or Mean Difficulty as a
    3D surface over the 7×7 sensor grid.  Surface replacement
    preserves the axes, wireframe, base labels, and view angle.

    Usage
    ─────
    monitor_3d.init_3d_monitor(word_grid)
    monitor_3d.update_data(Z_tot_new, Z_diff_new)   # each UI frame
    """

    def __init__(self):
        self.figure        = None
        self.axes_3d       = None
        self.X             = None
        self.Y             = None
        self.Z_tot         = np.zeros((GRID, GRID))
        self.Z_diff        = np.zeros((GRID, GRID))
        self.current_surf  = None
        self.current_mode  = 'tot'
        self.last_update   = 0.0
        self._radio        = None
        self._setup_done   = False

    def init_3d_monitor(self, word_grid: list) -> None:
        """
        PROCEDURE: init_3d_monitor

        Creates the 3D figure, plots the initial surface (ToT),
        adds wireframe overlay, base labels, and RadioButtons.
        """
        # Build meshgrid
        x = np.arange(GRID)
        y = np.arange(GRID)
        self.X, self.Y = np.meshgrid(x, y)

        # Create figure and 3D axes
        self.figure = plt.figure(figsize=(10, 7), facecolor=_BG_DARK)
        self.axes_3d = self.figure.add_subplot(111, projection='3d')
        self.axes_3d.set_facecolor(_BG_DARK)
        self.figure.patch.set_facecolor(_BG_DARK)

        # Plot initial surface (ToT)
        self.current_surf = self.axes_3d.plot_surface(
            self.X, self.Y, self.Z_tot,
            cmap='hot_r', alpha=0.9, edgecolor='none'
        )
        self.current_mode = 'tot'

        # Add wireframe overlay (persistent across toggles)
        self.axes_3d.plot_wireframe(
            self.X, self.Y, self.Z_tot,
            alpha=0.3, color='gray', linewidth=0.5
        )

        # Add base-plane labels (Z=0 plane, bottom of grid)
        self._add_base_labels(word_grid)

        # Configure axes
        self.axes_3d.set_xlabel('Column (0-6)', fontsize=10, color=_FG_PRIMARY)
        self.axes_3d.set_ylabel('Row (0-6)', fontsize=10, color=_FG_PRIMARY)
        self.axes_3d.set_zlabel('Time-on-Task (sec)', fontsize=10, color=_FG_PRIMARY)
        self.axes_3d.set_xlim(0, 6)
        self.axes_3d.set_ylim(0, 6)

        # Style 3D axes panes and tick labels
        self.axes_3d.tick_params(colors=_FG_MUTED)
        self.axes_3d.set_title(
            '3D Surface Monitor  [V-6]',
            color='white', fontsize=12, fontweight='bold', pad=15
        )

        # Set view angle (persistent across surface replacements)
        self.axes_3d.view_init(elev=35, azim=225)

        # Create RadioButtons widget
        radio_ax = self.figure.add_axes([0.7, 0.1, 0.15, 0.15])
        radio_ax.set_facecolor('#1a1a2e')
        self._radio = RadioButtons(
            ax=radio_ax,
            labels=['Time-on-Task', 'Mean Difficulty'],
            active=0
        )
        # Style the radio button labels
        for label in self._radio.labels:
            label.set_color(_FG_PRIMARY)
            label.set_fontsize(9)

        # Bind callback to toggle_z
        self._radio.on_clicked(self._on_radio_click)

        self.figure.canvas.draw_idle()
        self._setup_done = True

    def _add_base_labels(self, word_grid: list) -> None:
        """
        PROCEDURE: add_base_labels

        Place word labels on Z=0 base plane, slightly below zero.
        """
        label_z = 0 - 0.5  # slightly below zero

        for i in range(min(GRID, len(word_grid))):
            for j in range(min(GRID, len(word_grid[i]))):
                item = word_grid[i][j]
                # Handle (word, width) tuples and plain strings
                word = item[0] if isinstance(item, (tuple, list)) else item

                if word and word != "":
                    self.axes_3d.text(
                        x=j, y=i, z=label_z,
                        s=word,
                        fontsize=6, ha='center', va='top',
                        color='gray', alpha=0.7
                    )

    def _toggle_z(self, label_str: str) -> None:
        """
        PROCEDURE: toggle_z

        Core Algorithm: Surface Replacement

        Steps:
          1. Remove old surface (only the PolyCollection)
          2. Update Z-axis label
          3. Plot new surface
          4. Redraw
          5. Update state
        """
        # Throttle to 2fps (SURFACE_3D_UPDATE_INTERVAL = 0.5s)
        now = time.time()
        if (now - self.last_update) < SURFACE_3D_UPDATE_INTERVAL:
            return
        self.last_update = now

        # Determine mode from radio button label
        if label_str == 'Time-on-Task':
            new_mode = 'tot'
            Z_new = self.Z_tot
            zlabel = 'Time-on-Task (sec)'
        elif label_str == 'Mean Difficulty':
            new_mode = 'diff'
            Z_new = self.Z_diff
            zlabel = 'Mean Difficulty (D score)'
        else:
            return

        # Early exit if mode unchanged
        if new_mode == self.current_mode:
            return

        # --- Core Algorithm: Surface Replacement ---

        # STEP 1: Remove old surface (only the PolyCollection)
        if self.current_surf is not None:
            try:
                if self.current_surf in self.axes_3d.collections:
                    self.current_surf.remove()
            except (ValueError, AttributeError):
                pass  # already removed or stale reference
            # AXES OBJECT AND VIEW ANGLE PRESERVED ✓

        # STEP 2: Update Z-axis label
        self.axes_3d.set_zlabel(zlabel, fontsize=10, color=_FG_PRIMARY)

        # STEP 3: Plot new surface
        self.current_surf = self.axes_3d.plot_surface(
            self.X, self.Y, Z_new,
            cmap='hot_r', alpha=0.9, edgecolor='none'
        )
        # wireframe persists from init; keep old grid overlay

        # STEP 4: Redraw
        self.figure.canvas.draw_idle()

        # STEP 5: Update state
        self.current_mode = new_mode

        print("Toggled to: " + new_mode)

    def _on_radio_click(self, label: str) -> None:
        """
        PROCEDURE: on_radio_click

        Callback from RadioButtons.on_clicked().
        """
        self._toggle_z(label)

    def update_data(self, Z_tot_new: np.ndarray, Z_diff_new: np.ndarray) -> None:
        """
        Update the stored Z arrays with fresh data from Welford / EWIQR.

        If the current mode's data has changed, re-plot the surface.
        Throttled to 2fps.
        """
        if not self._setup_done:
            return

        self.Z_tot  = Z_tot_new.copy()
        self.Z_diff = Z_diff_new.copy()

        # Throttle surface re-plot to 2fps
        now = time.time()
        if (now - self.last_update) < SURFACE_3D_UPDATE_INTERVAL:
            return
        self.last_update = now

        # Re-plot the currently active surface with new data
        Z_active = self.Z_tot if self.current_mode == 'tot' else self.Z_diff

        if self.current_surf is not None:
            try:
                if self.current_surf in self.axes_3d.collections:
                    self.current_surf.remove()
            except (ValueError, AttributeError):
                pass

        self.current_surf = self.axes_3d.plot_surface(
            self.X, self.Y, Z_active,
            cmap='hot_r', alpha=0.9, edgecolor='none'
        )

        self.figure.canvas.draw_idle()


# ══════════════════════════════════════════════════════════════
# V-7: VELOCITY PROFILE OVERLAY — Last-N Touch Velocity Monitor
# ══════════════════════════════════════════════════════════════
#
# Algorithm: Overlay + Exponentially Weighted Mean
#
# Stores the last N (20) velocity arrays in a deque.  Each UI
# update draws:
#   - Past events as light gray lines (alpha=0.15)
#   - Most recent event as bold blue line (alpha=1.0)
#   - Weighted mean velocity as orange dashed line
#
# The weighted mean uses exponential decay (alpha_weight=0.15)
# so recent events dominate without a hard cliff.  Shorter
# arrays are zero-padded on the right to the length of the
# longest event in the window.
#
# Complexity
# ──────────
# on_frame()           : O(1) — deque append + timestamp check
# update_velocity_plot : O(N × L) — N events × max event length
# Memory               : O(N × L_avg)
# ══════════════════════════════════════════════════════════════


class VelocityProfileMonitor:
    """
    V-7: Velocity Profile Overlay.

    Overlays the last 20 touch velocity arrays on a single axes
    with an exponentially weighted mean.  Throttled at 5fps.

    Usage
    ─────
    vel_profile.init_velocity_plot()     # once, creates figure + axes
    vel_profile.on_frame(vel_array, ts)  # called per touch event
    # (the monitor updates its own plot internally)
    """

    def __init__(self,
                 n_overlay: int = VEL_PROFILE_N_OVERLAY,
                 alpha_weight: float = VEL_PROFILE_ALPHA_WEIGHT,
                 update_interval: float = VEL_PROFILE_UPDATE_INTERVAL):
        self._n_overlay       = n_overlay
        self._alpha_weight    = alpha_weight
        self._update_interval = update_interval

        self._velocity_history: deque = deque(maxlen=n_overlay)
        self._lock            = threading.Lock()

        # matplotlib objects (set up in init_velocity_plot)
        self.figure       = None
        self.axes         = None
        self.lines_past   = []       # list of Line2D (gray, alpha=0.15)
        self.line_recent  = None     # Line2D (bold blue)
        self.line_mean    = None     # Line2D (orange dashed)
        self._last_update = 0.0
        self._setup_done  = False
        self._pending_render = False  # set by metrics_thread, consumed by UI loop

    # ── setup ─────────────────────────────────────────────────

    def init_velocity_plot(self) -> None:
        """
        PROCEDURE: init_velocity_plot

        Creates the figure, axes, and all persistent Line2D artists.
        Past-event lines are pre-allocated for efficiency.
        """
        self.figure = plt.figure(figsize=(8, 5), facecolor=_BG_DARK)
        self.axes   = self.figure.add_subplot(111)
        self.axes.set_facecolor(_BG_DARK)
        self.figure.patch.set_facecolor(_BG_DARK)

        # Placeholder lines — most recent event (bold blue)
        self.line_recent, = self.axes.plot(
            [], [], color='#1f77b4', linewidth=2.5, alpha=1.0,
            label='Most recent'
        )

        # Weighted mean (orange dashed)
        self.line_mean, = self.axes.plot(
            [], [], color='#ff7f0e', linewidth=2, alpha=0.8,
            linestyle='--', label='Weighted mean'
        )

        # Pre-allocate past-event lines (N-1 gray lines)
        self.lines_past = []
        for _ in range(self._n_overlay - 1):
            line, = self.axes.plot(
                [], [], color='gray', linewidth=0.8, alpha=0.15
            )
            self.lines_past.append(line)

        # Zero reference line
        self.axes.axhline(
            y=0, color='white', linewidth=0.5, linestyle='-', alpha=0.3
        )

        # Labels and styling
        self.axes.set_xlabel('Step index', fontsize=9, color=_FG_MUTED)
        self.axes.set_ylabel('Velocity (cells/sec)', fontsize=9,
                             color=_FG_MUTED)
        self.axes.set_title(
            'Velocity Profile — last 20 touches  [V-7]',
            fontsize=11, fontweight='bold', color='white', pad=10
        )
        self.axes.legend(loc='upper right', fontsize=8, framealpha=0.3,
                         facecolor=_BG_DARK, edgecolor=_BG_BORDER,
                         labelcolor=_FG_PRIMARY)
        self.axes.grid(True, alpha=0.3, color=_GRID_COLOR)
        self.axes.tick_params(colors='#777777')
        for sp in self.axes.spines.values():
            sp.set_edgecolor(_GRID_COLOR)

        self.figure.tight_layout()
        self._setup_done = True

    # ── data ingestion ────────────────────────────────────────

    def on_frame(self, new_velocity_array: np.ndarray,
                 timestamp: float) -> None:
        """
        PROCEDURE: on_frame

        Called when a new touch event's velocity array is computed.
        Appends to the deque (auto-pops oldest if len > N) and
        triggers a throttled plot update.
        """
        if len(new_velocity_array) < 1:
            return  # skip events with no velocity information

        with self._lock:
            self._velocity_history.append(np.array(new_velocity_array))

        # Mark that new data is available for the main thread to render.
        # Do NOT call _update_velocity_plot here — this method runs in
        # metrics_thread.  Any matplotlib artist access from a background
        # thread crashes with RuntimeError: main thread is not in main loop.
        self._pending_render = True

    # ── weighted mean computation ─────────────────────────────

    @staticmethod
    def _compute_weighted_mean_velocity(
        vels: list, alpha_weight: float
    ) -> tuple:
        """
        PROCEDURE: compute_weighted_mean_velocity

        Aggregate velocity arrays with exponential decay: recent
        events (high index) have weight exp(alpha × (i − N)).
        Shorter arrays are zero-padded on the right.

        Returns (mean_vel, weights) or (None, None) if no valid data.
        """
        # Filter out events that are too short for velocity
        vels_valid = [v for v in vels if len(v) >= 2]
        if not vels_valid:
            return None, None

        max_len = max(len(v) for v in vels_valid)

        padded  = []
        weights = []

        for i, v in enumerate(vels_valid):
            # Pad shorter arrays with 0 on the right
            v_padded = np.pad(v, (0, max_len - len(v)),
                              mode='constant', constant_values=0)
            padded.append(v_padded)

            # Weight: recent events (high i) have exp(alpha × i)
            weight = np.exp(alpha_weight * (i - len(vels_valid)))
            weights.append(weight)

        # Normalize weights to sum=1
        weights_sum = sum(weights)
        if weights_sum <= 0:
            return None, None
        weights = [w / weights_sum for w in weights]

        # Weighted mean: sum(w_i × v_i) per step
        mean_vel = np.zeros(max_len)
        for i, v_pad in enumerate(padded):
            mean_vel += weights[i] * v_pad

        return mean_vel, weights

    # ── plot update ───────────────────────────────────────────

    def _update_velocity_plot(self, timestamp: float) -> None:
        """
        PROCEDURE: update_velocity_plot

        5-stage update:
          1. Plot all past events (light gray lines)
          2. Plot most recent event (bold blue)
          3. Plot weighted mean velocity (orange dashed)
          4. Auto-scale axes
          5. Redraw (draw_idle)
        """
        if not self._setup_done:
            return

        self._last_update = timestamp

        with self._lock:
            if len(self._velocity_history) == 0:
                return
            vels = list(self._velocity_history)  # snapshot

        N = len(vels)

        # --- Stage 1: Plot all past events (light gray lines) ---
        for i in range(N - 1):
            v = vels[i]
            if len(v) < 2:
                self.lines_past[i].set_data([], [])
                continue
            x = np.arange(len(v))
            self.lines_past[i].set_data(x, v)

        # Clear unused line slots if N < n_overlay
        for i in range(max(0, N - 1), len(self.lines_past)):
            self.lines_past[i].set_data([], [])

        # --- Stage 2: Plot most recent event (bold blue line) ---
        v_recent = vels[-1]
        if len(v_recent) >= 2:
            x_recent = np.arange(len(v_recent))
            self.line_recent.set_data(x_recent, v_recent)
        else:
            self.line_recent.set_data([], [])

        # --- Stage 3: Plot weighted mean velocity (orange dashed) ---
        mean_vel, _ = self._compute_weighted_mean_velocity(
            vels, self._alpha_weight
        )
        if mean_vel is not None:
            x_mean = np.arange(len(mean_vel))
            self.line_mean.set_data(x_mean, mean_vel)
        else:
            self.line_mean.set_data([], [])

        # --- Stage 4: Auto-scale axes ---
        all_vels = []
        for vel_arr in vels:
            if len(vel_arr) >= 2:
                all_vels.extend(vel_arr.tolist())

        if all_vels:
            v_max = max(all_vels)
            self.axes.set_ylim(-0.1, max(0.5, v_max * 1.1))

        max_step = max(len(v) for v in vels)
        self.axes.set_xlim(-1, max(2, max_step))

        # --- Stage 5: Trigger redraw ---
        # Skip draw_idle() here — the UI loop calls fig_menu.canvas.draw_idle()
        # unconditionally at the end of every frame.  Calling it here too
        # would cause a double-render and increase latency.
        # (Setting stale=True is enough for the main-loop draw_idle to pick up.)
        if self.axes is not None:
            self.axes.stale = True
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
