Shreyas-SK-21/Braille-Reading-Analysis-System/(commit log)

2026-05-27 added 2 finger and fixes
    [braille_ui.py]
2026-05-29 Changed the columns printed in man figure
2026-08-14 feat: UI redesign, DataLogger CSV/PNG export, weight presets, BOM, XOR checksum
    - Full PyQtGraph UI redesign: StatusBar with live pulse indicator + session
    timer, MetricCard grid (12 cards across 4 rows), WordStats scoreboard
    table, PlotPanel with sidebar button nav, all plots embedded in main
    window (no separate plot window), styled session summary dialog on close
    - DataLogger: session_data/ CSVs (touch_events + metrics_snapshots) written
    on every touch/5s, publication-quality PNGs generated at session end
    (wpm_trend, regression_chart, velocity_profile, path_efficiency,
    difficulty_heatmap) - all white background dpi=150 for paper use
    - Weight preset CLI flag: --weight-preset=d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
    [ESP32_code.ino, braille_ui.py]
2026-08-15 ran test runs
    [20260814_205713_metrics_snapshots.csv, 20260814_205713_touch_events.csv, 20260814_210006_metrics_snapshots.csv, 20260814_210006_touch_events.csv, 20260814_210251_metrics_snapshots.csv, 20260814_210251_touch_events.csv, 20260814_210314_metrics_snapshots.csv, 20260814_210314_touch_events.csv]
2026-08-15 test data added
    [20260814_212418_touch_events.csv]
2026-08-15 test6 added
    [20260815_111236_metrics_snapshots.csv, 20260815_111236_touch_events.csv]
2026-08-15 test7 added
    [20260815_112634_metrics_snapshots.csv, 20260815_112634_touch_events.csv]
2026-08-15 fixed UI name error crash
    [braille_ui.py]
2026-08-17 new run
    [20260814_205713_touch_events.csv, 20260814_210006_metrics_snapshots.csv, 20260814_210006_touch_events.csv, 20260814_210251_metrics_snapshots.csv, 20260814_210251_touch_events.csv, 20260814_210314_metrics_snapshots.csv, 20260814_210314_touch_events.csv, 20260814_211328_metrics_snapshots.csv]
2026-08-17 rows sweeped
    [20260817_224605_metrics_snapshots.csv, 20260817_224605_touch_events.csv, 20260817_225202_metrics_snapshots.csv, 20260817_225202_touch_events.csv, 20260817_230511_metrics_snapshots.csv, 20260817_230511_touch_events.csv]
2026-08-22 modularize; add heatmap csv exports; clean up paper figures
2026-08-22 audit fixes: example grid, benchmark rationale, clean prints
2026-08-25 inject real heatmap data (ToT, difficulty, coverage); add sensitivity analysis table
2026-08-28 feat: replace tabular heatmaps with stunning publication-ready seaborn graphics
2026-08-29 fix: regenerate all plots from consistent RUN1 data and annotate heatmaps with word mapping
2026-08-30 fix: compress legend sizes in Figs 4 and 5 by reducing font to tiny, tightening padding, and shortening legend lines
2026-08-30 fix: move Fig 5 legend to top-right to avoid velocity curve overlap
2026-09-03 fix: apply comprehensive IEEE format corrections - fix broken \ref, KHz->kHz, orphan comma, htbp->!htp, duplicate sentence, wider Table I and heatmaps, IRB sentence, Figure sentence-initial capitaliz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
2026-09-03 fix: remove aggressive -6mm vspace after Fig 7 and 8 captions causing section header and body text overlap, shorten caption notes, and normalize heatmap widths
2026-09-03 fix: apply remaining audit fixes - clarify representative dataset, detail BOM components, explain omitted words in Fig 6, and update Fig 8 colormap description
2026-09-03 fix: replace 'Fifth' with 'Fish' in all data CSVs and regenerate the three heatmap PDFs (tot, diff, skip) to maintain consistency
    [20260824_001119_coverage_heatmap.csv, 20260824_001119_difficulty_heatmap.csv, 20260824_001119_tot_heatmap.csv, 20260824_001119_touch_events.csv]
2026-09-04 fix: aggressive space optimizations to resolve 7-page limit overflow (condensed figure widths, replaced itemized list with inline text, tightened float spacing in preamble, and reduced vspace around 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
